joshua-jerred/Giraffe/hardware/readme.md

# Giraffe Hardware

- KiCad 7+
- All symbols should be in the `./symbols/` directory
- All footprints should be in the `./footprints/` directory

Slowly moving to a more modular design and better documentation.

## Flight Computer
- ./giraffe_flight_computer/
- ./power_board/
