joshua-jerred/Giraffe/src/power_board_pico/README.md

# Power Board Pico

Start of a pico/rp2040 project.

## External Comms

Comms via basic UART interface.

### Commands

All commands start with `cmd ` followed by the command and arguments.

- `cmd gps nav` get gps nav data

- `cmd nv test` test non-volatile memory
