joshua-jerred/Giraffe/hardware/power_calculation.md

# Hardware Power Calculation

| Item | Idle | Max | Est. |
| --- | --- | --- | ---- |
| Pi Zero 2 | 110ma@5v | 300ma@5v | |
