joshua-jerred/Giraffe/docs/hardware/battery_pack_design.md

# Battery Pack Design

The battery pack is a simple 18650 cell holder with 3d printed parts.
