joshua-jerred/Giraffe/docs/ground_station.md

# Ground Station

[ground_station](uml/giraffe_software_topology.puml)

!include tic_seq_api_calls.puml
