joshua-jerred/Giraffe/docs/ports.md

GFS Socket: 7893
GGS Backend HTTP: 7892
Web Server: 3000
MySQL: 3306
