joshua-jerred/Giraffe/docs/status_led.md

# Status LED

## Green

- Solid: Flight Phase in Pre-Launch
- Blinking: Flight Phase in Launch/Recovery
- Off: Ascent/Descent

## Blue

- Blinking: Extension module starting/inactive extensions

## Red

- Blinking: Active Error
