joshua-jerred/Giraffe/docs/giraffe_paths.md

# Giraffe Paths

## Primary Directory

The configuration and data files for Giraffe will be stored in the user's home
directory in a folder called `.giraffe`. This folder will be created if it does
not already exist.

In the ground station, all file paths are created in `file_paths.js`.
