joshua-jerred/Giraffe/docs/acronyms.md

Using acronyms because I can and I like to keep it confusing:

- GFS: Giraffe Flight System

- GFC: Giraffe Flight Computer
  - GFC Hat: The Giraffe Flight Computer Hat (Top PCB)
  - GFC Shoe: The Giraffe Flight Computer Shoe (Bottom PCB)

- GGS: Giraffe Ground Station

- GWC: Giraffe Web Client

- GDL: Giraffe Data Link
