joshua-jerred/Giraffe/hardware/power_board/giraffe_flight_computer_footprints/MolexSmaConnector.step

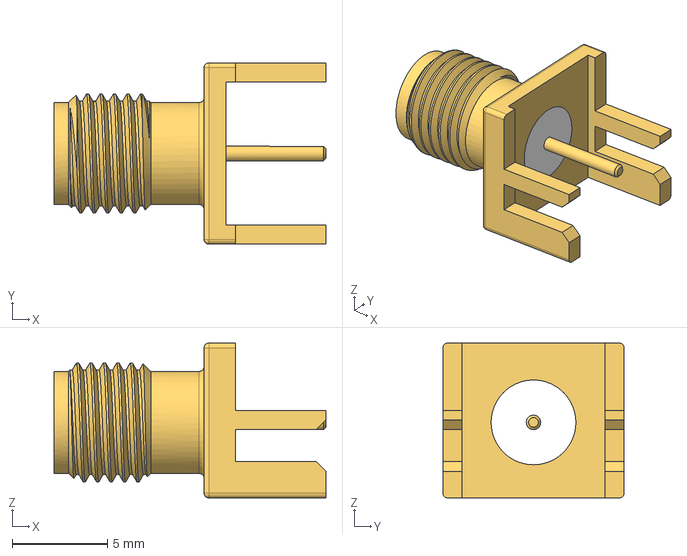
[picture p2: CAD file, 2024-01-05]
hardware/power_board/giraffe_flight_computer_footprints/MolexSmaConnector.step
14.3 x 9.53 x 8.12 mm
