joshua-jerred/Giraffe/hardware/Prototype Boards/5v Buck Supply V2/footprints/5015.step

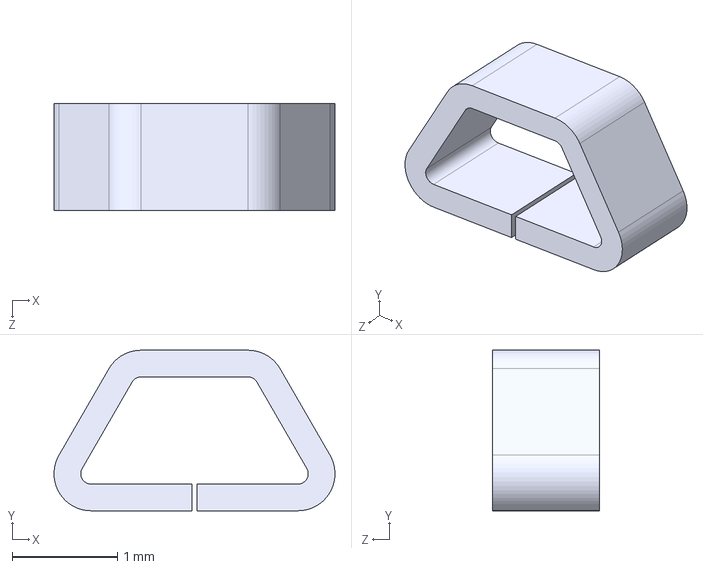
[picture p3: CAD file, 2024-10-27]
hardware/Prototype Boards/5v Buck Supply V2/footprints/5015.step
2.67 x 1.52 x 1.02 mm
