joshua-jerred/Giraffe/hardware/Prototype Boards/5v Buck Supply V2/tmp_import/INA2180A1IDGKR/INA2180A1IDGKR.step

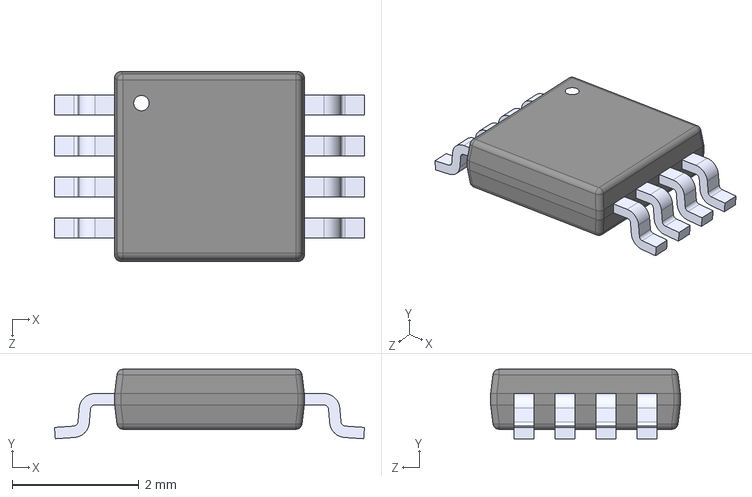
[picture p4: CAD file, 2024-10-27]
hardware/Prototype Boards/5v Buck Supply V2/tmp_import/INA2180A1IDGKR/INA2180A1IDGKR.step
4.90 x 1.10 x 3.00 mm
