joshua-jerred/Giraffe/hardware/Prototype Boards/5v Buck Supply V2/tmp_import/INA4180A1IPWR/INA4180A1IPWR.step

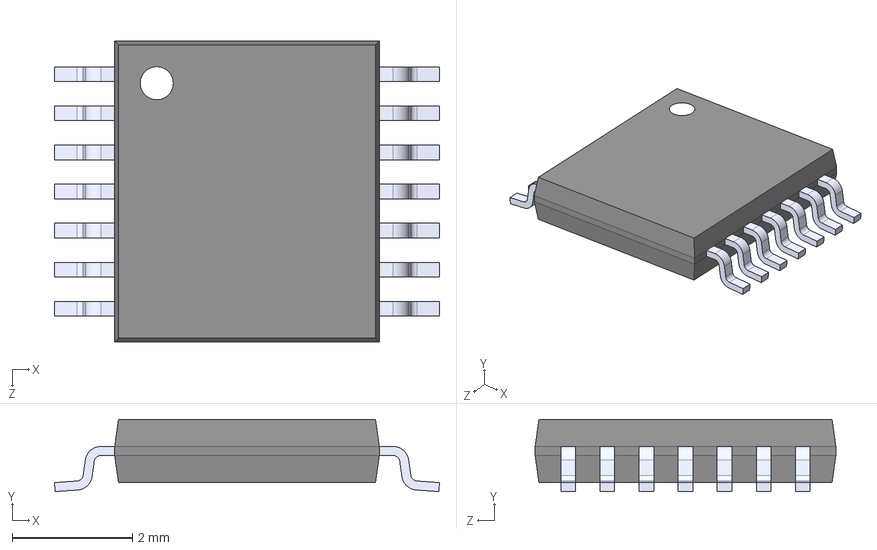
[picture p5: CAD file, 2024-10-27]
hardware/Prototype Boards/5v Buck Supply V2/tmp_import/INA4180A1IPWR/INA4180A1IPWR.step
6.40 x 1.20 x 5.00 mm
