joshua-jerred/Giraffe/hardware/flight_enclosure/enclosure.FCStd

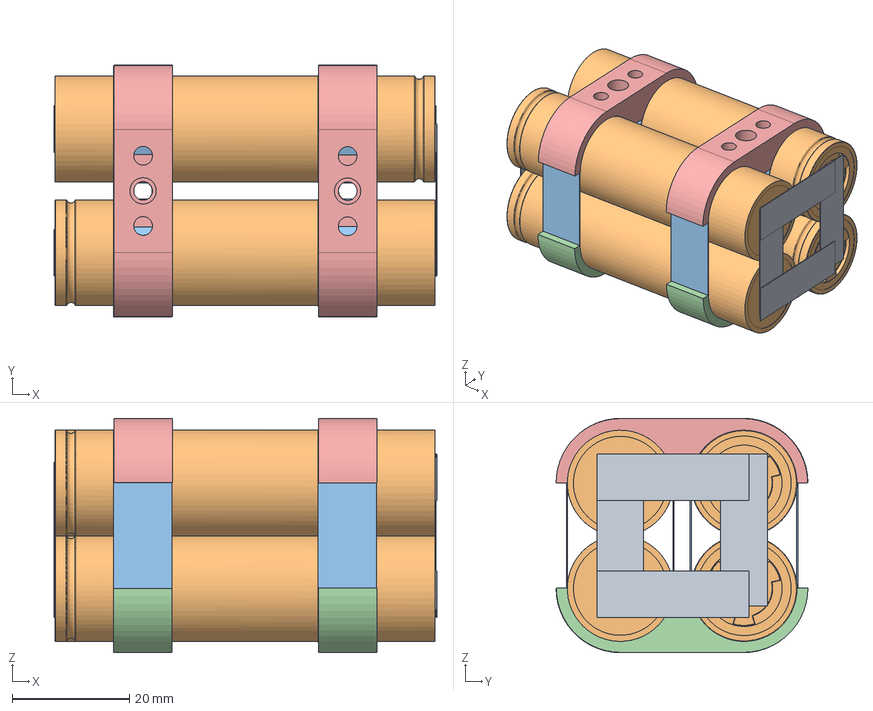
[picture p6: CAD file, 2025-07-18]
hardware/flight_enclosure/enclosure.FCStd
65.5 x 43.1 x 40.1 mm
nickel_strip x 6
kaptop_tape_wrap x 4
18650_cell_holder_bottom x 2
18650_cell_holder_top x 2
