joshua-jerred/Giraffe/hardware/giraffe_flight_computer/giraffe_flight_computer_footprints/SAM-M8Q-0.STEP

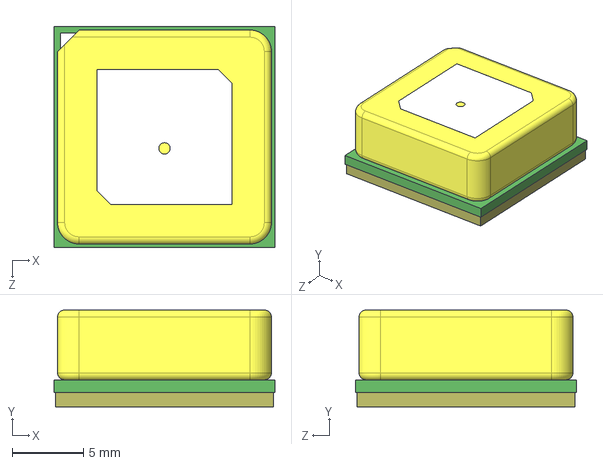
[picture p7: CAD file, 2025-07-18]
hardware/giraffe_flight_computer/giraffe_flight_computer_footprints/SAM-M8Q-0.STEP
15.5 x 6.80 x 15.5 mm
