joshua-jerred/Giraffe/hardware/power_board/giraffe_flight_computer_footprints/CAT24C32WI_GT3.step

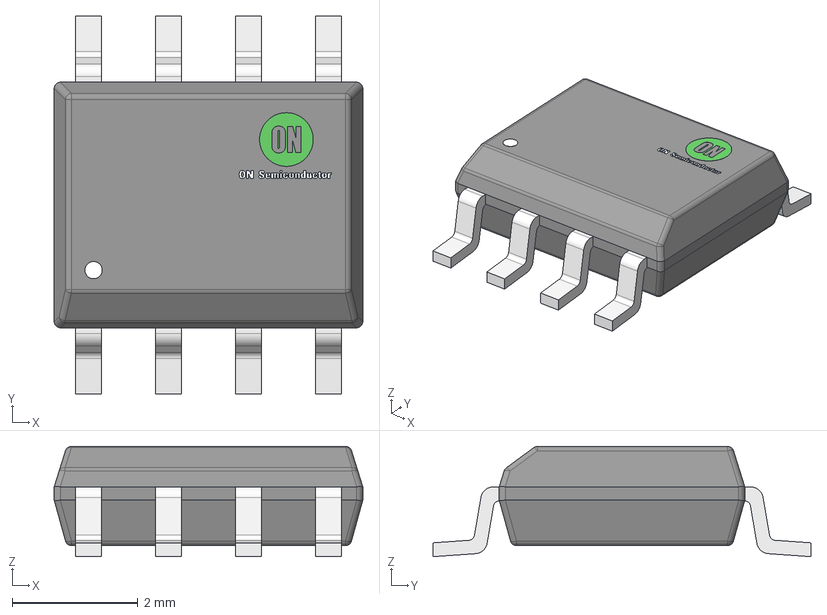
[picture p8: CAD file, 2024-01-05]
hardware/power_board/giraffe_flight_computer_footprints/CAT24C32WI_GT3.step
4.90 x 6.00 x 1.75 mm
