joshua-jerred/Giraffe/hardware/Prototype Boards/5v Buck Supply V2/footprints/INA180A1IDBVT.step

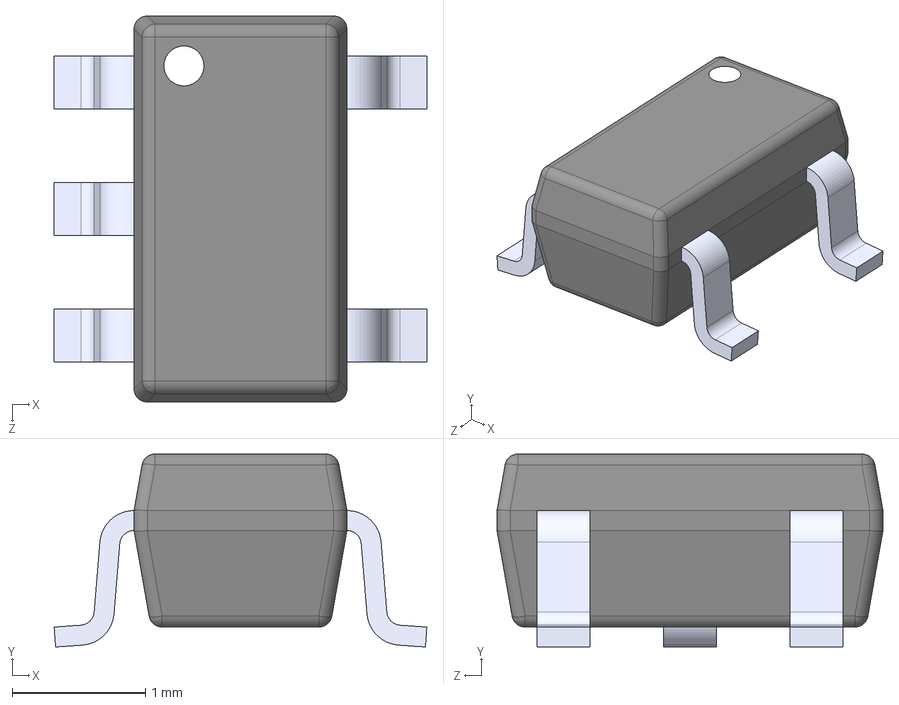
[picture p9: CAD file, 2024-10-27]
hardware/Prototype Boards/5v Buck Supply V2/footprints/INA180A1IDBVT.step
2.80 x 1.45 x 2.90 mm
