joshua-jerred/Giraffe/hardware/power_board/giraffe_flight_computer_footprints/BMI088.step

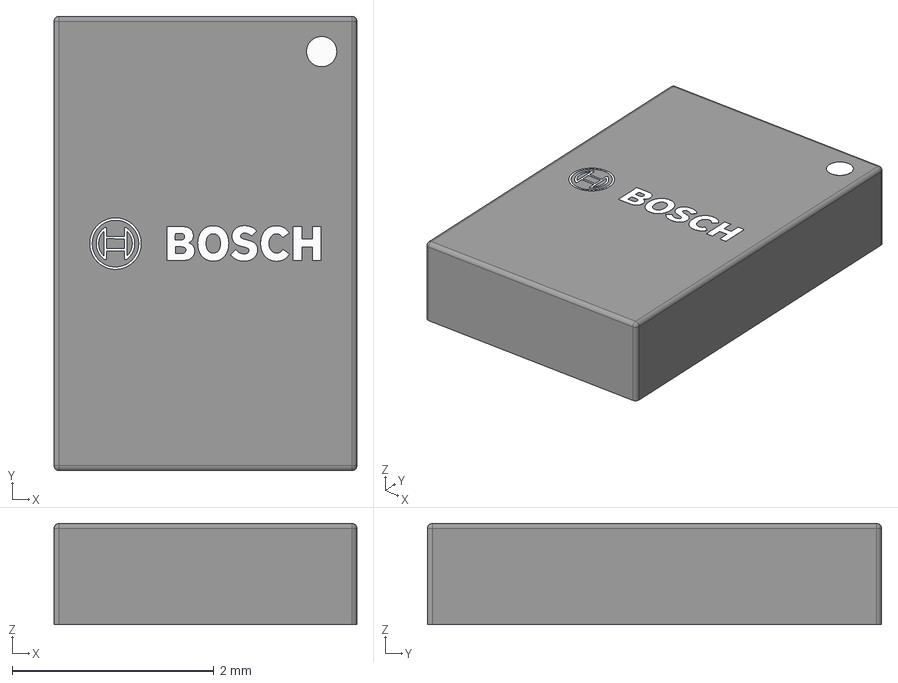
[picture p10: CAD file, 2024-01-05]
hardware/power_board/giraffe_flight_computer_footprints/BMI088.step
3.00 x 4.50 x 1.00 mm
Package
Pads
Mark1
Mark2
Logo
