joshua-jerred/Giraffe/hardware/power_board/giraffe_flight_computer_footprints/Murata_-_LQH3NPH680MMEL.step

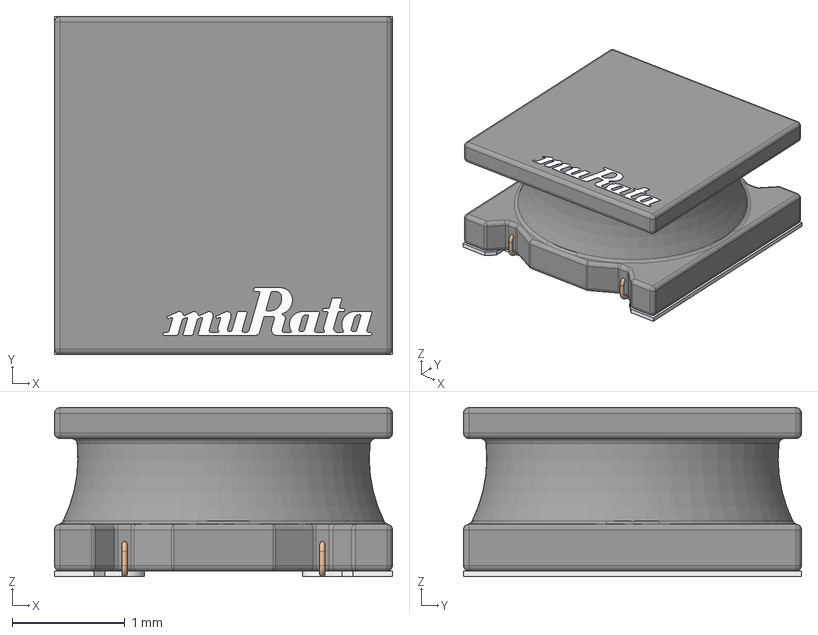
[picture p11: CAD file, 2024-01-05]
hardware/power_board/giraffe_flight_computer_footprints/Murata_-_LQH3NPH680MMEL.step
3.00 x 3.00 x 1.50 mm
logo
terminals
wire
