joshua-jerred/Giraffe/hardware/giraffe_flight_computer/giraffe_flight_computer_footprints/SRU1048-100Y.step

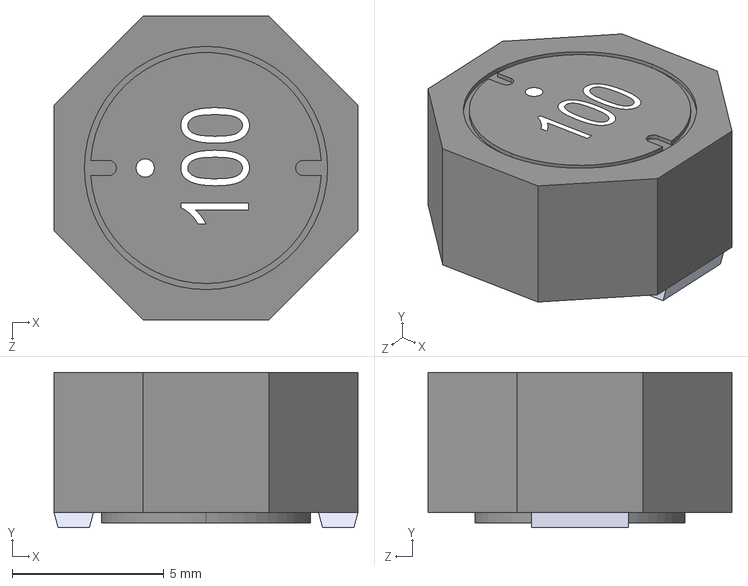
[picture p12: CAD file, 2024-10-27]
hardware/giraffe_flight_computer/giraffe_flight_computer_footprints/SRU1048-100Y.step
10.0 x 5.10 x 10.0 mm
