joshua-jerred/Giraffe/hardware/2171790001.stp

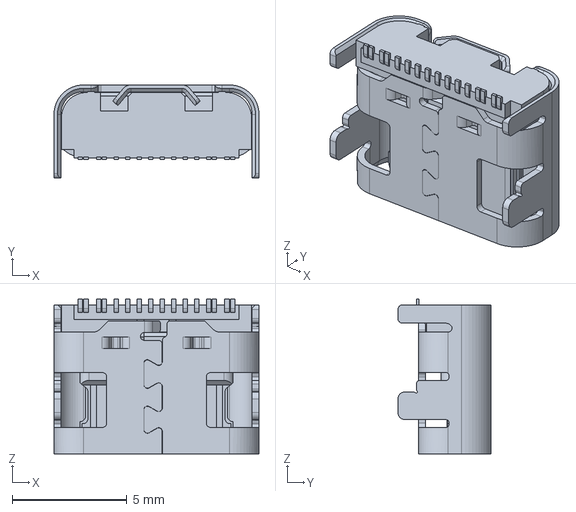
[picture p13: CAD file, 2025-07-18]
hardware/2171790001.stp
8.94 x 4.06 x 6.75 mm
