joshua-jerred/Giraffe/hardware/giraffe_flight_computer/giraffe_flight_computer_footprints/5037630491.stp

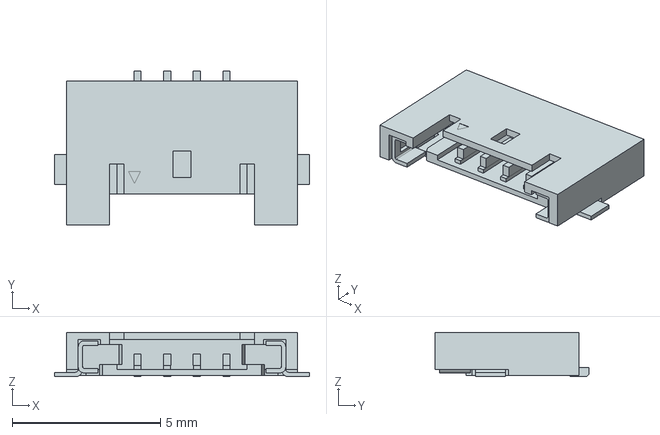
[picture p14: CAD file, 2025-07-18]
hardware/giraffe_flight_computer/giraffe_flight_computer_footprints/5037630491.stp
8.60 x 5.19 x 1.50 mm
