joshua-jerred/Giraffe/hardware/Prototype Boards/5v Buck Supply V2/tmp_import/TPS54302DDCR/TPS54302DDCR.step

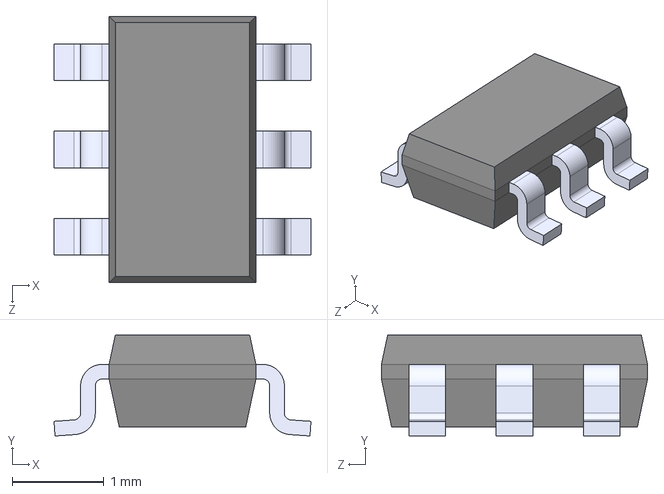
[picture p15: CAD file, 2024-10-27]
hardware/Prototype Boards/5v Buck Supply V2/tmp_import/TPS54302DDCR/TPS54302DDCR.step
2.80 x 1.10 x 2.90 mm
