joshua-jerred/Giraffe/hardware/giraffe_flight_computer/giraffe_flight_computer_footprints/436500301.stp

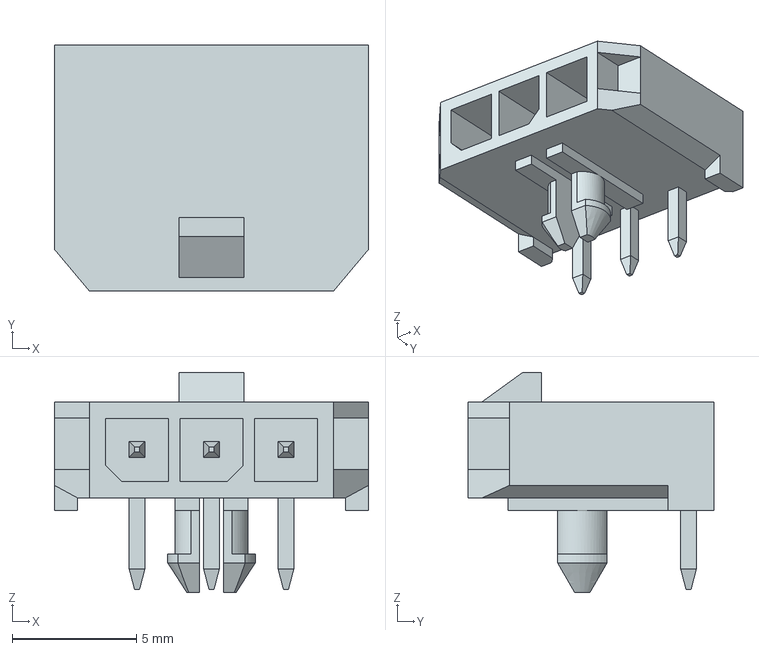
[picture p16: CAD file, 2025-07-18]
hardware/giraffe_flight_computer/giraffe_flight_computer_footprints/436500301.stp
12.7 x 9.90 x 8.87 mm
