joshua-jerred/Giraffe/(list of files, cad)

Other CAD files:
hardware/flight_enclosure/battery_pack.FCStd
hardware/giraffe_flight_computer/giraffe_flight_computer_footprints/MAX11613EUAT.step
