joshua-jerred/Giraffe/tests/test-list.md

# Unit Tests
Uses gtest, many of these are out of date and need to be updated.

## Test List
- [Test 01] - Data Stream
- [Test 02] - Configuration Module
- [Test 03] - Data Module
- [Test 04] - Extension Module (Not Yet Implemented)
- [Test 05] - I2C Interface
- [Test 06] - BMP180 Extension
- [Test 07] - DS18B20 Extension
- [Test 08] - u-blox UBX Utility test
- [Test 09] - u-blox UBX Manual Test
- [Test 10] - BME280 Extension
- [Test 11] - SYSINFO Extension
- [Test 12] - MCP3021 Extension
- [Test 13] - Image Processing Utility
- [Test 14] - Serial Interface
