joshua-jerred/Giraffe/tests/test-13/test-image.png

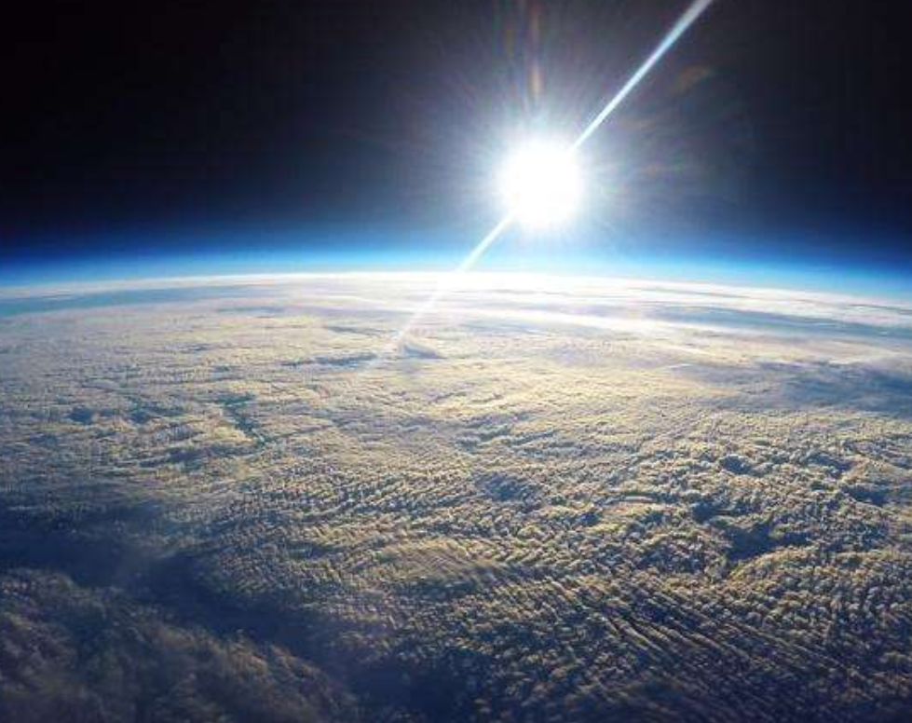
tests/test-13/test-image.png
