joshua-jerred/Giraffe/(threads)

Thread 6 (2022-10-15):

Implement Error Frame

joshua-jerred, 2022-10-15:
Implement an error frame similar to the data frame. Utilize the expiry time to clear errors.
This needs to be done with either a vector, map, or queue.

If the expiration time is '0' the error does not expire.

Closed 2022-10-31.

Thread 8 (2022-10-15):

Fix the shutdown process

joshua-jerred, 2022-10-15:
The shutdown is currently an absolutely unsafe disaster as there are many threads that are killed during the shutdown. CTRL+C is handled but it currently doesn't do anything.

The shutdown function should request that all sensors stop and shut down before turning off.
May need to implement some form of an interrupt within the modules/extensions that use threading.
_____
Edit:
Segfault on exit currently as the extensions are trying to access the data stream when it does not exist.

Closed 2022-10-26.

Thread 19 (2022-10-26):

Console Module - Include error frame

joshua-jerred, 2022-10-26:

Closed 2022-10-31.

Thread 30 (2022-11-03):

SAM-M8Q Extension

joshua-jerred, 2022-11-03:

joshua-jerred, 2022-12-28:
Eventually needs to be redone with SPI instead of DDC as even 'basic' GPS data messages are ~95 bytes. I'm not all that happy with the u-blox implementation of I2C via DDC, but they ensure that you can verify data integrity. It does still work perfectly along side another I2C sensor 151c58173fe88556e30dce18381f897edefdf0bb

Closed 2022-12-28.

Thread 39 (2022-12-11):

BME280 Driver

joshua-jerred, 2022-12-11:
The BMP180 is no longer made and there are better options.

Look into:
BMP390
BME280 - Contains RH and Temperature in a similar package size

joshua-jerred, 2022-12-19:
Going with the BME280, need to create an extension for this sensor (I2C)

joshua-jerred, 2022-12-31:
15cafeb3d115dfe9757dc09af1d4fe57048497b0

Basic driver implemented

Closed 2022-12-31.

Thread 40 (2022-12-11):

Extension shutdown

joshua-jerred, 2022-12-11:
Extension shutdown is currently really messy and often results in seg faults. This needs to be fixed.

joshua-jerred, 2022-12-16:
Fixed in [6c97428d59c64374747a181c28abdd812ccbb2c0](https://github.com/joshua-jerred/Giraffe/commit/6c97428d59c64374747a181c28abdd812ccbb2c0)

Closed 2022-12-16.

Thread 43 (2022-12-17):

Prepare development branch for merge

joshua-jerred, 2022-12-17:
Prepare 0.2 for merge
- [x] fix and remaining small bugs
- [x] remove residual files
- [x] update change log in doc
- [x] fix unit tests for current changes

Closed 2022-12-17.

Thread 47 (2022-12-19):

I2C utility needs better error handling

joshua-jerred, 2022-12-19:

joshua-jerred, 2022-12-20:
Fixed the majority of problems and added better error handling/safety.
17609eb8bf8b683ef3c91415e47f77881737d0ba

The Linux kernel I2C header is supposedly not thread-safe, so this will have to be updated at some point.

Closed 2022-12-20.

Thread 51 (2022-12-21):

Thread safe I2C Transactions

joshua-jerred, 2022-12-21:
Implement 'utility-interface-control.h' into I2C

joshua-jerred, 2023-01-04:
24b8e0c5fffe347b482f4ab4776dde5a63b8f6dd

Closed 2023-01-04.

Thread 52 (2022-12-21):

'DataModule::checkForStaleErrors()' segfault

joshua-jerred, 2022-12-21:
Segfault in the data module when checking for stale errors.
```c++
  for (auto& [source_and_unit, packet] : errorframe_) {
    if (packet.expiration_time == 0) {  // 0 means it never expires
      continue;
    }
    if ((int)packet.expiration_time < (int)now) {
      errorframe_.erase(source_and_unit);
    }
  }
```
Valgrind output:
```
==209221== Thread 2:
==209221== Invalid read of size 8
==209221==    at 0x178962: std::__detail::_Hash_node<std::pair<std::__cxx11::basic_string<char, std::char_traits<char>, std::allocator<char> > const, ErrorStreamPacket>, true>::_M_next() const (hashtable_policy.h:283)
==209221==    by 0x177B8E: std::__detail::_Node_iterator_base<std::pair<std::__cxx11::basic_string<char, std::char_traits<char>, std::allocator<char> > const, ErrorStreamPacket>, true>::_M_incr() (hashtable_policy.h:300)
==209221==    by 0x176F77: std::__detail::_Node_iterator<std::pair<std::__cxx11::basic_string<char, std::char_traits<char>, std::allocator<char> > const, ErrorStreamPacket>, false, true>::operator++() (hashtable_policy.h:352)
==209221==    by 0x175BAA: DataModule::checkForStaleErrors() (module-data.cpp:204)
==209221==    by 0x175C6D: DataModule::runner() (module-data.cpp:231)
==209221==    by 0x17C7FB: void std::__invoke_impl<void, void (DataModule::*)(), DataModule*>(std::__invoke_memfun_deref, void (DataModule::*&&)(), DataModule*&&) (invoke.h:74)
==209221==    by 0x17C74E: std::__invoke_result<void (DataModule::*)(), DataModule*>::type std::__invoke<void (DataModule::*)(), DataModule*>(void (DataModule::*&&)(), DataModule*&&) (invoke.h:96)
==209221==    by 0x17C6AE: void std::thread::_Invoker<std::tuple<void (DataModule::*)(), DataModule*> >::_M_invoke<0ul, 1ul>(std::_Index_tuple<0ul, 1ul>) (std_thread.h:253)
==209221==    by 0x17C663: std::thread::_Invoker<std::tuple<void (DataModule::*)(), DataModule*> >::operator()() (std_thread.h:260)
==209221==    by 0x17C643: std::thread::_State_impl<std::thread::_Invoker<std::tuple<void (DataModule::*)(), DataModule*> > >::_M_run() (std_thread.h:211)
==209221==    by 0x49582B2: ??? (in /usr/lib/x86_64-linux-gnu/libstdc++.so.6.0.30)
==209221==    by 0x4C43B42: start_thread (pthread_create.c:442)
==209221==  Address 0x4e38130 is 0 bytes inside a block of size 152 free'd
==209221==    at 0x484BB6F: operator delete(void*, unsigned long) (in /usr/libexec/valgrind/vgpreload_memcheck-amd64-linux.so)
```

joshua-jerred, 2022-12-21:
```c++
  ErrorFrame::iterator it = errorframe_.begin();
  while (it != errorframe_.end()) {
    if (it->second.expiration_time == 0) { // 0 mean it never expires}
      it++;
      continue;
    }
    if ((int)it->second.expiration_time < (int)now) {
      it = errorframe_.erase(it); // erase returns the next iterator
    } else {
      it++;
    }
  }
```

The iterator was being deleted, a simple fix.

7a86255bd87e4a414d93750587fa75f2e5a4e0d2

Closed 2022-12-21.

Thread 56 (2022-12-27):

Finalize Extension List

joshua-jerred, 2022-12-27:
### Environmental
- [x] Pressure Sensor (BME280)
- [x] Temperature Sensor(s) (DS18B20, BME280)
- [x] Humidity Sensor (BME280)
- [x] Light Sensor(s) UVA, UVB, UVC, or wide spectrum UV sensor. Visible spectrum sensor for RGB.
      - TSL25911FN
      -  LTR390

### Location/Physical Sensors
- [x] GPS Sensor (SAM-M8Q)
- [x] Accelerometer / Gyro (BMI055)

### System Sensors
- [x] Voltage/Battery Fuel Gauge sensor (MAX17048G)
- [x] On PCB Thermocouple - Not needed. Between the BME280 on the board and CPU temp, this isn't that important.

### Radio
- [x] VHF Radio Module (DRA818)
- [x] Audio Input/Output for radio (TI PCM2902C)

Closed 2023-01-02.

Thread 61 (2023-01-02):

UBX Protocol - Poll data instead of streaming it

joshua-jerred, 2023-01-02:

joshua-jerred, 2023-01-05:
d8551d8689bac853fadae47fe5ba43d966cfc4c2 As good as this is going to get for now, eventually, another method needs to be used. Either SPI or hand the work over to an MCU that will read and parse the data that can then be read via simple I2C commands.

Closed 2023-01-05.

Thread 63 (2023-01-07):

Prepare for Merge of the 0.3 iteration development branch with main

joshua-jerred, 2023-01-07:
- [x] Fix all file Doxygen headers
- [x] Prepare hardware for unit tests
- [x] Finish refactor #54
- [x] Change all version numbers
- [x] Run a 'comprehensive' test on the GFS in the Pi Environment
- [x] Pass all unit tests
- [x] Generate and Publish Doxygen docs
- [x] Update Readme
  - [x] Publish Schematic for GFC Prototype 2
  - [x] Updated image of the web server

Closed 2023-01-07.

Thread 68 (2023-01-22):

Implement - Configuration error detection/error catching (General Configuration Safety)

joshua-jerred, 2023-01-22:
This is the most 'unsafe' part of GFS currently. The JSON library is throwing exceptions and they are not being caught.

Every configuration item needs to do some form of error detection as well.

A large overhaul of the Configuration Module may be needed.

Closed 2023-05-23.

Thread 69 (2023-01-22):

Implement - Log Levels

joshua-jerred, 2023-01-22:
A more universal approach to the 'errorStream'

- [ ] - [ ] Configuration
   - [ ]  Log Level
   - [ ]  Print Log
- [ ] Data Stream
  - [ ] Change 'ErrorPacket' and supporting methods to 'LogPacket'
  - [ ] Add 'level' to LogPacket

  The following will only do something if the configured error level is at that level, or lower.
  - [ ] addDebug()
  - [ ] addInfo()
  - [ ] addCritical()
  - [ ] addWarn()
  - [ ] Update addError()

- [ ] Data Module
  - [ ] Parse the LogPacket/DebugPacket
      - [ ] Debug Packets: Write to a file or print output
  - [ ] Critical/Warn/Error
      - [ ] These need to go into what was previously called the 'error frame'

Thread 71 (2023-01-22):

Implement - Location Data

joshua-jerred, 2023-01-22:
The Data Module needs to parse GPS packets as they arrive to maintain the following in the data stream:

- [x] Last Good GPS Fix
- [x] Current GPS Data
   - [x] Includes 'GPS Status' which is a boolean value that is set to true if the GPS packets are arriving
   - [ ] An expiration time (currently undefined) will state when the data is no longer considered good

joshua-jerred, 2023-03-21:
60f16c055d345da12f81e3e93f51ab75563ef235

Closed 2023-03-21.

Thread 76 (2023-01-22):

Fix - Use Available Memory, not Free Memory

joshua-jerred, 2023-01-22:
Currently the system extension is using 'Free Memory' which is not useful as Linux will use as much as it can. Available memory is more more relevant.

Closed 2023-06-24.

Thread 101 (2023-06-02):

Implement - Data Module Info/Error log to file

joshua-jerred, 2023-06-02:
Inside of `data_log.cpp`.

The function prototype is already there.

Closed 2023-06-08.

Thread 110 (2023-06-30):

Feature/DataModule/FileLog/Errors

joshua-jerred, 2023-06-30:
Errors (log items) need to be implemented to file logging.

- [x] As they come in
- [x] The current active errors for a given time, including none

Closed 2023-07-01.

Thread 111 (2023-06-30):

Feature/DataModule/DataFrame/Voltages

joshua-jerred, 2023-06-30:
A data frame should be generated for voltages along with the relevant data IDs

- Bus Voltages
- Battery Voltages

Closed 2024-10-28.

Thread 117 (2023-06-30):

Feature/DataModule/ErrorFrame

joshua-jerred, 2023-06-30:
A map of errors:

```
errorMap[ErrorId]: ErrorContainer

struct ErrorContainer{
 MostRecentTimestamp // The timestamp of the last time it was thrown
 TimesReported // The current number of error reports, this will be non-zero
// Items should be logged prior to clearing
// Remove from the map once cleared
}
```

Closed 2023-07-01.

Thread 122 (2023-06-30):

Feature/Extension/BMP180Update

joshua-jerred, 2023-06-30:
Re-Implement the extension

joshua-jerred, 2024-01-16:
Not needed anymore. BME280 is the replacement device

Closed 2024-01-16.

Thread 171 (2024-01-13):

TCP Socket Reliability

joshua-jerred, 2024-01-13:
The current TCP socket implementation in not reliable. Although it's functional, it has all sorts of problems with the current ground station.

Thread 207 (2024-02-15):

Hard Fault on invalid bme280 config

joshua-jerred, 2024-02-15:
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

joshua-jerred, 2024-02-15:
The fault is not related to the config. However, the issue with the config was treating the bme280 enabled option as a string.

joshua-jerred, 2024-02-15:
The current assumption is that it's related to the following lines as it has only been seen soon after adding a samm8q in the config.

https://github.com/joshua-jerred/Giraffe/blob/c79d168e90ba4295580119f2163c120147790046/src/flight_system/extensions/samm8q.cpp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

Data reliability with the SAMM8Q needs to be revisited. See issue #210

Closed 2024-02-15.

Thread 210 (2024-02-15):

SAM-M8Q Data Reliability

joshua-jerred, 2024-02-15:
Currently, the SAM-M8Q extension will generate erroneous data. This might be related to using I2C as it has been a challenge. CRC checking should also be inspected.

Examples:
https://github.com/joshua-jerred/Giraffe/blob/c79d168e90ba4295580119f2163c120147790046/src/flight_system/extensions/samm8q.cpp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

This raises a fault at times. Values will be wildly erroneous even in valid frames.

Thread 211 (2024-02-15):

BME280 Pressure Reliability

joshua-jerred, 2024-02-15:
The pressure data from the BME280 is reliant on "compensation data". If this data is reliant on the temperature, this could cause issues with the pressure data as the sensor is on the PCB and will probably be *much* warmer than the outside air.

Thread 212 (2024-02-15):

Allow For GFS Address changes

joshua-jerred, 2024-02-15:
Currently, changing the address of GFS requires a restart of the GGS. Implement a change so that the GGS does not need to be reset when the user changes the address.

Thread 214 (2024-02-15):

Implement generic 'Flight Logic'

joshua-jerred, 2024-02-15:
Create a way to quickly add logic that can control/look at:
- Flight Phase (see dependent issues)
- Battery Saving Mode
- Send Alerts if GPS data is lost

Closed 2024-06-08.

Thread 215 (2024-02-15):

Implement 'Flight Phase'

joshua-jerred, 2024-02-15:
Dependent on #214

Flight Phases:
- [x] Pre-Launch: Starting mode, ~~(no telemetry?)~~
- [x] Launch: Switch from pre-launch is a manual switch made via a command sent via TCP (Web Client)
- [x] Ascent: The switch from launch to ascent should happen as soon as the flight computer begins to increase in altitude.
- [x] Descent: Dependent on detecting a balloon pop (Separate Issue)
- [x] Recovery: Switch to this mode when the flight computer has landed.

Flight Phase needs to be added to flight_runner_data so that it's immune to hard faults.

The current flight phase also needs to be within shared data

Add the data to the data stream and the server module.

Closed 2024-06-08.

Thread 233 (2024-02-15):

Plan battery voltage/soc data location

joshua-jerred, 2024-02-15:
Possibly dependent on #234

In the flight software, where does SOC/battery voltage come from? It will originally come from an ADC extension, but will it come in as the raw data, or as something else?

Closed 2024-10-28.

Thread 234 (2024-02-15):

ADC Channel Mapping

joshua-jerred, 2024-02-15:
First, determine how to differentiate the labels of ADC channels. Currently, the data module supports single channel ADCs well as they have unique extension names, but if there are multiple inputs this could cause problems. One idea is to generate unique enum values for channels 0-n (probably 0-7 for now, no idea why more would be needed).

Thread 262 (2024-04-26):

Implement 'mission clock'

joshua-jerred, 2024-04-26:
The ground station and the web client both need to be aware of the 'mission clock'.
A launch time should be set via the web client and sent to the flight software.

- Mission clock display on the web client with start time, and time elapsed.
- Have a method to reset this clock and to pause it.
- This will be used to do sequencing on the FC side
- Need to detect clock sway, especially when on the ground.

Closed 2024-06-08.

Thread 282 (2024-10-20):

IMU Axis Remap

joshua-jerred, 2024-10-20:
This doesn't necessarily have to be in the config JSON, but there must exist a way to to re-map the orientation of an IMU to allow for them to be installed in any way.
