joshua-jerred/Giraffe/hardware/GFC Hat/GFC-Hat.kicad_pcb

## KiCad design hardware/Prototype Boards/legacy/GFC Hat/GFC-Hat.kicad_pcb (2023-06-30, an earlier design)

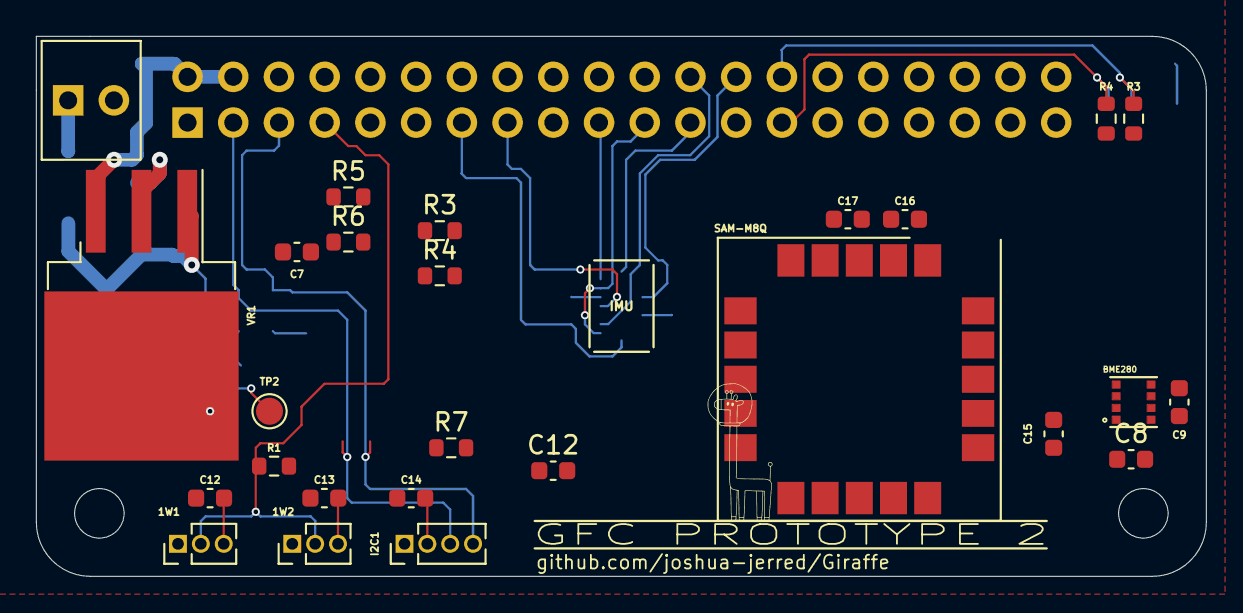
[picture p21: board GFC-Hat.kicad_pcb from above]

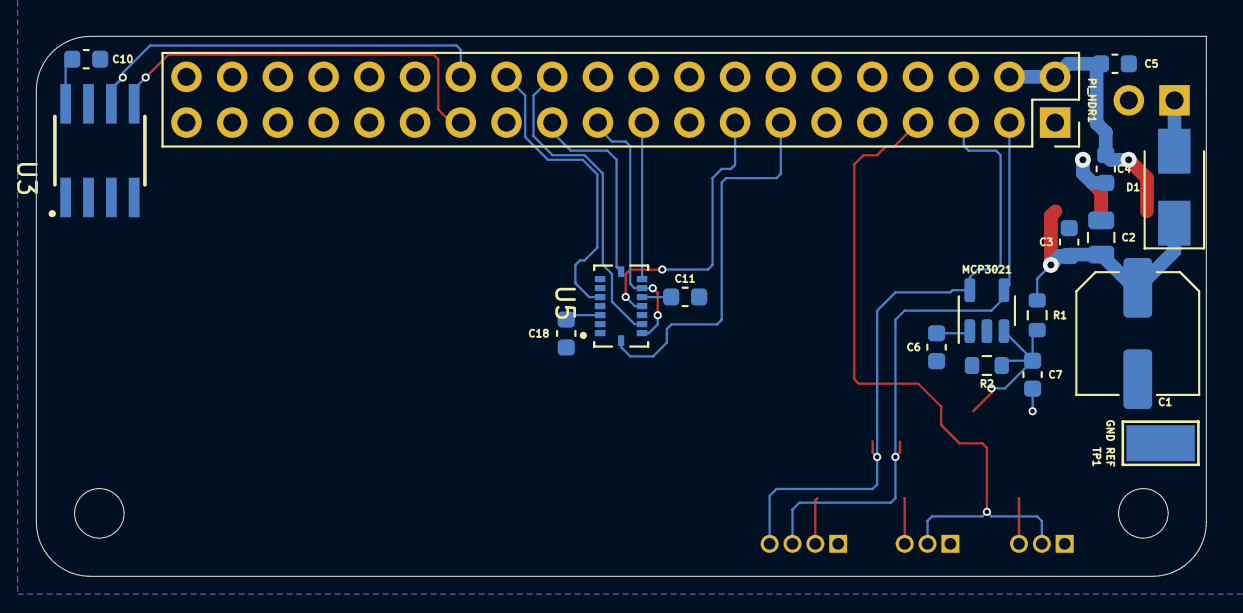
[picture p22: board GFC-Hat.kicad_pcb from below]

Board: 4 copper layers, 65.0 x 30.0 mm, 44 parts (18 on the bottom side), 19 nets.

Parts:
1W1, 1W2: 1-Wire; PinHeader_1x03_P1.27mm_Vertical
C1: 100µF; C_Elec_6.3x7.7
C2: 1µF; C_0805_2012Metric
C3, C4, C5, C6, C7, C7#2, C8, C9, C10, C11, C12, C12#2, C13, C14, C15, C16, C17, C18: 0.1µF; C_0603_1608Metric
D1: 2A LFV; D_SMA
I2C1: I²C; PinHeader_1x04_P1.27mm_Vertical
J1: BAT; OSTVN02A150 2x1 Terminal Block
PI_HDR1: PI; PinSocket_2x20_P2.54mm_Vertical
R1, R1#2: 30kΩ; R_0603_1608Metric
R2: 7.5kΩ; R_0603_1608Metric
R3, R3#2, R4, R4#2: 3.9kΩ; R_0603_1608Metric
R5, R6: *; R_0603_1608Metric
R7: 4.7kΩ; R_0603_1608Metric
TP1: GND REF; TestPoint_Keystone_5019_Minature
TP2: BAT REF; TestPoint_Pad_D1.5mm
U1: MCP3021; SOT-23-5
U2: BME280; PSON65P250X250X100-8N
U3: CAT24C32; SOIC127P600X175-8N
U4: SAM-M8Q; ublox_SAM-M8Q
U5: BMI088; PQFN50P450X300X100-16N
VR1: LM7805; TO-263-3_TabPin2

Connections:
1-Wire: 1W1.2, 1W2.2, PI_HDR1.7 (GCLK0/GPIO4), R7.2
+3V3: 1W1.3, 1W2.3, C6.2, C8.2, C9.2, C10.2, C11.2, C12.2, C12#2.2, C13.2, C14.1, C15.2, C16.2, C17.1, C18.2, I2C1.2, PI_HDR1.1 (3V3), PI_HDR1.17 (3V3), R3.1, R3#2.1, R4.1, R4#2.1, R5.1, R6.2, R7.1, U1.1 (VDD), U2.2 (CSB), U2.6 (VDDIO), U2.8 (VDD), U3.8 (VCC), U4.2 (VCC_IO), U4.3 (V_BCKP), U4.17 (VCC), U5.3 (VDD), U5.11 (VDDIO)
+5V: C4.1, C5.2, PI_HDR1.2 (5V), PI_HDR1.4 (5V), VR1.3 (VO)
+BATT: D1.2 (A), J1.1
/BAT Reference Voltage: C7.2, C7#2.2, R1.2, R1#2.2, R2.1, TP2.1, U1.3 (A_IN)
BAT Polarized: C1.1, C2.1, C3.1, D1.1 (K), R1.1, R1#2.1, VR1.1 (VI)
BMI088 Int1: PI_HDR1.33 (PWM1/GPIO13), U5.16 (INT1)
BMI088 Int3: PI_HDR1.15 (GPIO22), U5.12 (INT3)
EEPROM.SCL: PI_HDR1.28 (ID_SC/GPIO1), R4.2, R4#2.2, U3.6 (SCL)
EEPROM.SDA: PI_HDR1.27 (ID_SD/GPIO0), R3.2, R3#2.2, U3.5 (SDA)
GND: 1W1.1, 1W2.1, C1.2, C2.2, C3.2, C4.2, C5.1, C6.1, C7.1, C7#2.1, C8.1, C9.1, C10.1, C11.1, C12.1, C12#2.1, C13.1, C14.2, C15.1, C16.1, C17.2, C18.1, I2C1.1, J1.2, PI_HDR1.6 (GND), PI_HDR1.9 (GND), PI_HDR1.14 (GND), PI_HDR1.20 (GND), PI_HDR1.25 (GND), PI_HDR1.30 (GND), PI_HDR1.34 (GND), PI_HDR1.39 (GND), R2.2, TP1.1, U1.2 (GND), U2.1 (GND), U2.5 (SDO), U2.7 (GND), U3.1 (A0), U3.2 (A1), U3.3 (A2), U3.4 (VSS), U4.1 (GND), U4.4 (GND), U4.5 (GND), U4.6 (GND), U4.10 (GND), U4.11 (GND), U4.15 (GND), U4.16 (GND), U4.20 (GND), U5.2 (NC), U5.4 (GNDA), U5.6 (GNDIO), U5.7 (PS), VR1.2 (GND)
GPS TX-Ready: PI_HDR1.37 (GPIO26), U4.13 (TXD)
I2C0.SCL: I2C1.3, PI_HDR1.5 (SCL/GPIO3), R6.1, U1.5 (SCL), U2.4 (SCK), U4.12 (SCL)
I2C0.SDA: I2C1.4, PI_HDR1.3 (SDA/GPIO2), R5.2, U1.4 (SDA), U2.3 (SDI), U4.9 (SDA)
SPI0.CE0: PI_HDR1.24 (~CE0/GPIO8), U5.14 (CSB1)
SPI0.CE1: PI_HDR1.26 (~CE1/GPIO7), U5.5 (CSB2)
SPI0.MISO: PI_HDR1.21 (MISO0/GPIO9), U5.10 (SDO2), U5.15 (SDO1)
SPI0.MOSI: PI_HDR1.19 (MOSI0/GPIO10), U5.9 (SDA/SDI)
SPI0.SCLK: PI_HDR1.23 (SCLK0/GPIO11), U5.8 (SCL/SCK)
