joshua-jerred/Giraffe/hardware/Prototype Boards/5v Buck Supply V2/5v Buck Supply.kicad_pcb

## KiCad design hardware/Prototype Boards/5v Buck Supply V2/5v Buck Supply.kicad_pcb (2025-07-18)

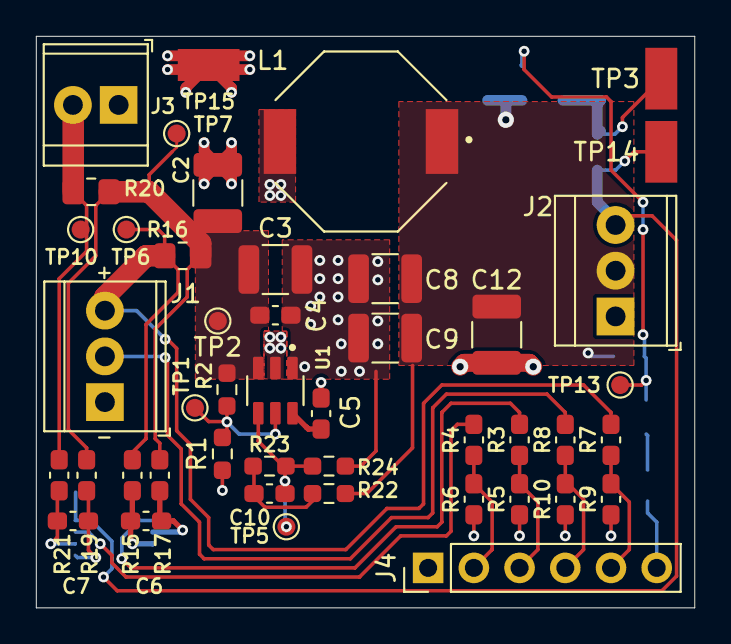
[picture p23: board hardware/Prototype Boards/5v Buck Supply V2/5v Buck Supply.kicad_pcb from above]

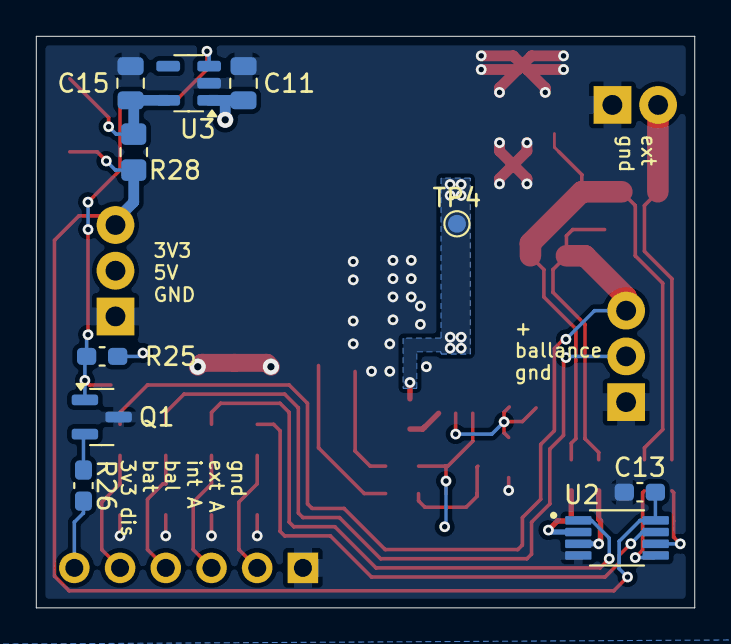
[picture p24: board hardware/Prototype Boards/5v Buck Supply V2/5v Buck Supply.kicad_pcb from below]

Board: 2 copper layers, 36.6 x 31.8 mm, 55 parts (10 on the bottom side), 26 nets.

Parts:
C2, C12: DNS; C_1210_3225Metric_Pad1.33x2.70mm_HandSolder
C3: 10uf; C_1210_3225Metric
C4, C5, C13: 0.1uf; C_0603_1608Metric_Pad1.08x0.95mm_HandSolder
C6, C7: DNS; C_0603_1608Metric_Pad1.08x0.95mm_HandSolder
C8, C9: 22uf; C_1210_3225Metric
C10: 75pf; C_0603_1608Metric_Pad1.08x0.95mm_HandSolder
C11, C15: 1uf; C_0805_2012Metric
J1: BATT; TerminalBlock_TE_282834-3_1x03_P2.54mm_Horizontal
J2: PRIMARY; TerminalBlock_TE_282834-3_1x03_P2.54mm_Horizontal
J3: EXTERNAL; TerminalBlock_TE_282834-2_1x02_P2.54mm_Horizontal
J4: IO; PinHeader_1x06_P2.54mm_Vertical
L1: 10uH; IND_SRU1048-100Y
Q1: NPN; SOT-23
R1, R2: DNS; R_0603_1608Metric_Pad0.98x0.95mm_HandSolder
R3, R4, R5, R6, R7, R8, R9, R10, R25, R26: R; C_0603_1608Metric_Pad1.08x0.95mm_HandSolder
R15, R17, R19, R21: 0; C_0603_1608Metric_Pad1.08x0.95mm_HandSolder
R16, R20, R28: R; R_0805_2012Metric_Pad1.20x1.40mm_HandSolder
R22: 49.9k; R_0603_1608Metric_Pad0.98x0.95mm_HandSolder
R23: 100k; R_0603_1608Metric_Pad0.98x0.95mm_HandSolder
R24: 13.3k; R_0603_1608Metric_Pad0.98x0.95mm_HandSolder
TP1, TP6, TP7, TP10: TestPoint; TestPoint_Pad_D1.0mm
TP2, TP4, TP5, TP13: TestPoint_Pad_D1.0mm
TP3, TP14, TP15: TestPoint; KEYSTONE_5015
U1: TPS54302DDCR; SOT95P280X110-6N
U2: INA2180Ax; SOP65P490X110-8N
U3: AP2112K-3.3; SOT-23-5

Connections:
3V3 Primary: C13.1, J2.3, R28.2, TP14.1, U2.8 (VS)
3V3_DISABLE: J4.6, R26.2
5V Primary: C8.1, C9.1, C11.1, C12.1, J2.2, L1.1, R22.1, R25.2, U3.1 (VIN)
+BATT: J1.3, R7.1, R15.1, R16.1, TP6.1
+BATT External: J3.2, R20.2, R21.1, TP10.1
+BATT Primary: C2.1, C3.1, C4.1, R2.2, R16.2, R17.1, R19.1, R20.1, TP2.1, TP7.1, U1.3 (VIN)
/3v3_en: Q1.1 (C), R25.1, TP13.1, U3.3 (EN)
/3v3_out: C15.1, R28.1, TP3.1, U3.5 (VOUT)
/adc_scaled:batt: J4.5, R7.2, R9.1
/adc_scaled:batt_ballance: J4.4, R8.2, R10.1
/adc_scaled:current_batt: J4.3, R3.2, R5.1
/adc_scaled:current_external: J4.2, R4.2, R6.1
/batt_ext+: C7.2, R19.2, U2.5 (IN+2)
/batt_ext-: C7.1, R21.2, U2.6 (IN-2)
/batt_primary+: C6.2, R15.2, U2.3 (IN+1)
/batt_primary-: C6.1, R17.2, U2.2 (IN-1)
/buck_boot: C5.1, U1.6 (BOOT)
/buck_enable: R1.2, R2.1, TP1.1, U1.5 (EN)
/buck_feedback: C10.2, R23.2, R24.1, TP5.1, U1.4 (FB)
/buck_sw: C5.2, L1.2, TP4.1, U1.2 (SW)
GND: C2.2, C3.2, C4.2, C8.2, C9.2, C11.2, C12.2, C13.2, C15.2, J1.1, J2.1, J3.1, J4.1, Q1.3 (E), R1.1, R5.2, R6.2, R9.2, R10.2, R24.2, TP15.1, U1.1 (GND), U2.4 (GND), U3.2 (GND)
unnamed: C10.1, R22.2, R23.1
unnamed: Q1.2 (B), R26.1
batt_ballance: J1.2, R8.1
current_sense_batt: R3.1, U2.1 (OUT1)
current_sense_external: R4.1, U2.7 (OUT2)
