joshua-jerred/Giraffe/hardware/GFC Shoe/GFC Shoe.kicad_pcb

## KiCad design hardware/Prototype Boards/legacy/GFC Shoe/GFC Shoe.kicad_pcb (2023-03-24, an earlier design)

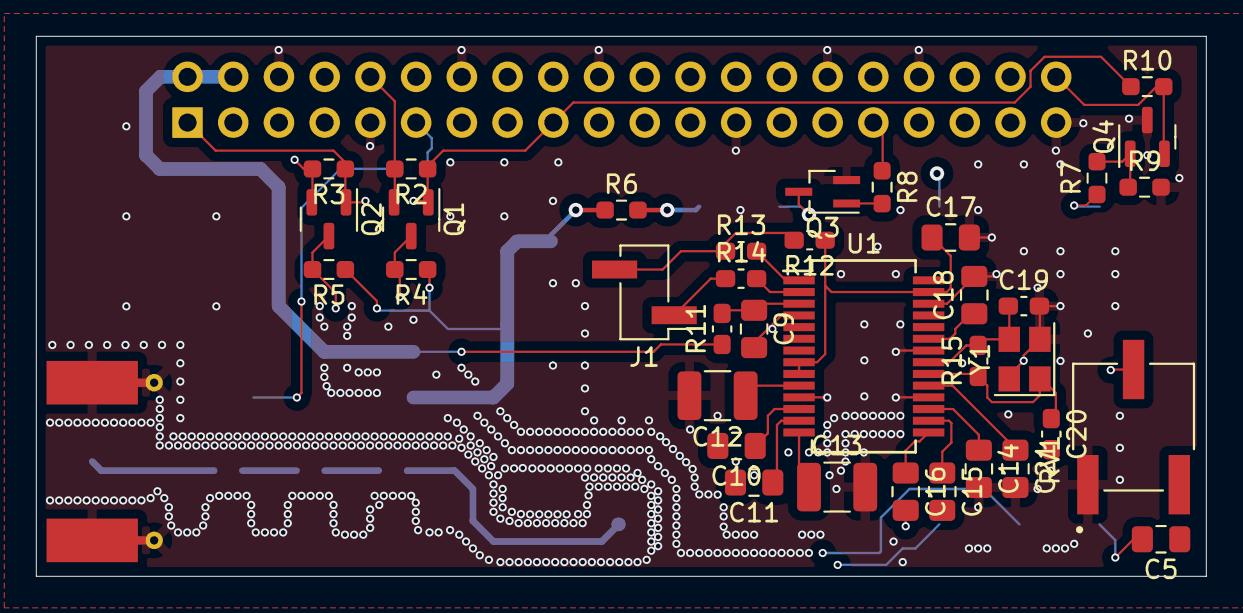
[picture p25: board GFC Shoe.kicad_pcb from above]

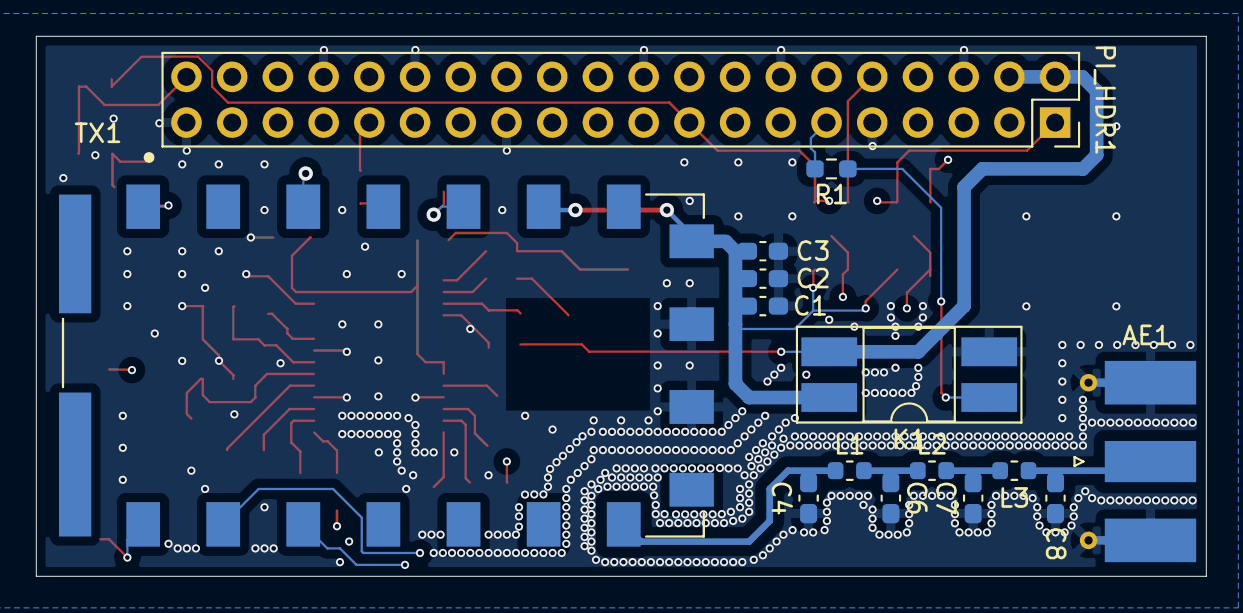
[picture p26: board GFC Shoe.kicad_pcb from below]

Board: 4 copper layers, 65.0 x 30.0 mm, 51 parts (15 on the bottom side), 42 nets.

Parts:
AE1: Antenna_Shield; SMA_Molex_73251-1153_EdgeMount_Horizontal
C1: 0.1uF; C_0603_1608Metric_Pad1.08x0.95mm_HandSolder
C2: 10kpF; C_0603_1608Metric_Pad1.08x0.95mm_HandSolder
C3: 1kpF; C_0603_1608Metric_Pad1.08x0.95mm_HandSolder
C4, C8: 20pF; C_0603_1608Metric_Pad1.08x0.95mm_HandSolder
C5, C9, C10, C11, C14, C15, C16, C17, C18, C21: 1uF; C_0805_2012Metric_Pad1.18x1.45mm_HandSolder
C6, C7: 36pF; C_0603_1608Metric_Pad1.08x0.95mm_HandSolder
C12, C13: 10uF; C_1210_3225Metric_Pad1.33x2.70mm_HandSolder
C19, C20: 10pF; C_0603_1608Metric_Pad1.08x0.95mm_HandSolder
J1: USB; PinHeader_1x02_P2.54mm_Vertical_SMD_Pin1Left
K1: TLP241A; DIP-4_W8.89mm_SMDSocket_LongPads
L1, L3: 56nH; L_0603_1608Metric
L2: 68nH; L_0603_1608Metric
PI_HDR1: PI; PinSocket_2x20_P2.54mm_Vertical
Q1, Q2: BSS138; SOT-23
Q3: DMN67D8LW-13; SOT-323_SC-70_Handsoldering
Q4: Q_NPN_BCE; SOT-23
R1: 270; R_0603_1608Metric_Pad0.98x0.95mm_HandSolder
R2, R3, R4, R5, R8: 10k; R_0603_1608Metric_Pad0.98x0.95mm_HandSolder
R6: 10K; R_0603_1608Metric_Pad0.98x0.95mm_HandSolder
R7: 100K; R_0603_1608Metric_Pad0.98x0.95mm_HandSolder
R9: 56K; R_0603_1608Metric_Pad0.98x0.95mm_HandSolder
R10: 1K; R_0603_1608Metric_Pad0.98x0.95mm_HandSolder
R11: 2.2; C_0603_1608Metric_Pad1.08x0.95mm_HandSolder
R12: 1.5k; C_0603_1608Metric_Pad1.08x0.95mm_HandSolder
R13, R14: 22; C_0603_1608Metric_Pad1.08x0.95mm_HandSolder
R15: 1M; C_0603_1608Metric_Pad1.08x0.95mm_HandSolder
RV1: 100k; TRIM_3361P-1-104GLF
TX1: SA868; DORJI_DRA818V
U1: PCM2902C; SSOP-28_5.3x10.2mm_P0.65mm
Y1: Crystal ECS33B; Crystal_SMD_3225-4Pin_3.2x2.5mm

Connections:
5VC: C1.2, C2.2, C3.2, K1.4 (Drain), R4.1, R5.1, R6.1, TX1.8 (VBAT)
+3V3: PI_HDR1.1 (3V3), PI_HDR1.17 (3V3), Q1.1 (G), Q2.1 (G), R2.1, R3.1, R10.1
+5V: K1.3 (Drain), PI_HDR1.2 (5V), PI_HDR1.4 (5V), R11.1
/SA868/A_IN: C16.2, RV1.2
/SA868/A_IN Filtered: C5.2, TX1.18 (MIC_IN)
/SA868/A_OUT: C11.2, TX1.3 (AF_OUT)
/SA868/PD: R6.2, TX1.6 (PD)
/SA868/PTT: Q3.3 (D), TX1.5 (PTT)
/SA868/RF OUT: C4.1, L1.1, TX1.12 (ANT)
/SA868/RF_OUT_FILTERED: AE1.1 (A), C8.1, L3.2
/SA868/RXD 5V: Q2.3 (D), R5.2, TX1.16 (RXD)
/SA868/Radio UART RX: PI_HDR1.8 (GPIO14/TXD), Q2.2 (S), R3.2
/SA868/Radio UART TX: PI_HDR1.10 (GPIO15/RXD), Q1.2 (S), R2.2
/SA868/SQ: R7.1, TX1.1 (SQ)
/SA868/TXD 5V: Q1.3 (D), R4.2, TX1.17 (TXD)
/Sound Card/D+: J1.2, R12.2, R13.1
/Sound Card/D-: J1.1, R14.1
GND: AE1.2 (Shield), C1.1, C2.1, C3.1, C4.2, C6.2, C7.2, C8.2, C9.2, C12.2, C13.2, C14.2, C17.2, C18.2, C19.2, C20.2, C21.2, K1.2 (Cathode), PI_HDR1.6 (GND), PI_HDR1.9 (GND), PI_HDR1.14 (GND), PI_HDR1.20 (GND), PI_HDR1.25 (GND), PI_HDR1.30 (GND), PI_HDR1.34 (GND), PI_HDR1.39 (GND), Q3.2 (S), Q4.3 (E), R9.2, RV1.1, TX1.9 (GND), TX1.10 (GND), U1.4 (DGNDU), U1.11 (AGNDC), U1.18 (AGNDP), U1.22 (AGNDX), U1.26 (DGND), Y1.2, Y1.4
GPIO PTT: PI_HDR1.31 (GCLK2/GPIO6), R8.1
GPIO SQ: PI_HDR1.40 (GPIO21/SCLK1), Q4.2 (C), R10.2
unnamed: C5.1, RV1.3
unnamed: C6.1, L1.2, L2.1
unnamed: C7.1, L2.2, L3.1
unnamed: C9.1, R11.2, U1.3 (VBUS)
unnamed: C10.1, U1.12 (VINL)
unnamed: C11.1, U1.13 (VINR)
unnamed: C12.1, U1.10 (VCCCI)
unnamed: C13.1, U1.14 (VCOM)
unnamed: C14.1, U1.17 (VCCP1I)
unnamed: C15.1, U1.16 (VOUTL)
unnamed: C16.1, U1.15 (VOUTR)
unnamed: C17.1, R12.1, U1.8 (SEL0), U1.9 (SEL1), U1.27 (VDDI)
unnamed: C18.1, U1.23 (VCCXI)
unnamed: C19.1, R15.2, U1.21 (XTI), Y1.3
unnamed: C21.1, U1.19 (VCCP2I)
unnamed: K1.1 (Anode), R1.1
unnamed: Q3.1 (G), R8.2
unnamed: Q4.1 (B), R7.2, R9.1
unnamed: R13.2, U1.1 (D+)
unnamed: R14.2, U1.2 (D-)
unnamed: C20.1, R15.1, U1.20 (XTO), Y1.1
Radio Power Control: PI_HDR1.11 (GPIO17), R1.2
