joshua-jerred/Giraffe/hardware/giraffe_flight_computer/giraffe_flight_computer.kicad_pcb

## KiCad design hardware/giraffe_flight_computer/giraffe_flight_computer.kicad_pcb (2025-07-18)

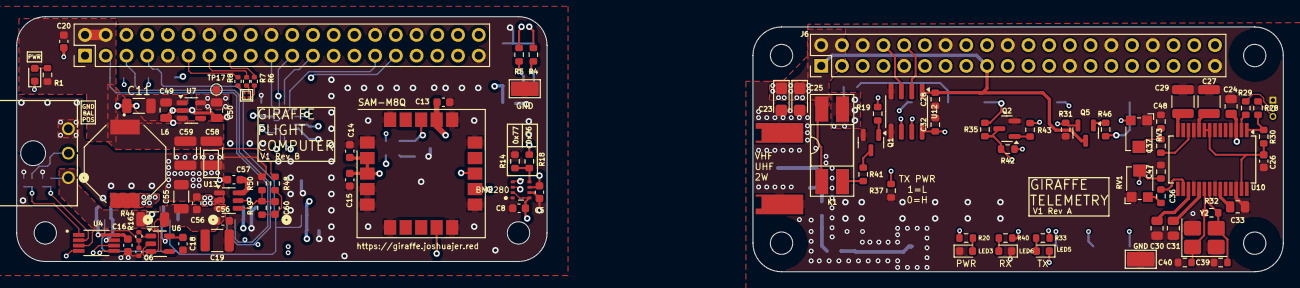
[picture p27: board giraffe_flight_computer.kicad_pcb from above]

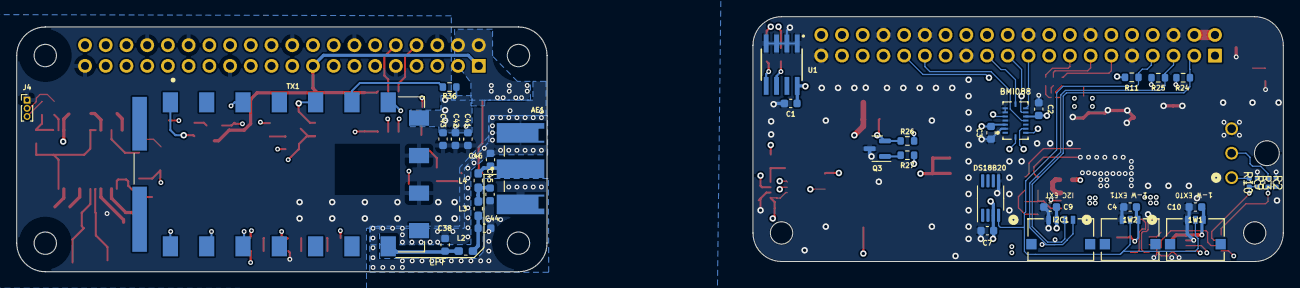
[picture p28: board giraffe_flight_computer.kicad_pcb from below]

Board: 4 copper layers, 155.2 x 31.3 mm, 129 parts (37 on the bottom side), 84 nets.

Parts:
1W1: 1W1; CONN_5037630000-SD_03_MOL
1W2: 1W2; CONN_5037630000-SD_03_MOL
AE1: ANT; MolexSmaConnector
C1, C2, C3, C4, C5, C7, C8, C9, C10, C13, C14, C15, C16, C18, C20, C41, C56, C56#2, C57: 0.1µF; C_0603_1608Metric
C6: C_Small; C_0402_1005Metric
C11: 10uf; C_1206_3216Metric
C19, C58, C59: 22µF; C_1210_3225Metric
C23, C25: 10μF; CP_EIA-3216-18_Kemet-A
C24, C31, C33: 1μF; R_0805_2012Metric
C26: 1μF; C_0603_1608Metric
C27, C29: 10μF; R_1210_3225Metric
C28, C32, C39, C40: 0.1μF; R_0603_1608Metric
C30: 1uF; R_0805_2012Metric
C36, C37: 1μF; R_0603_1608Metric
C38, C46: 20pF; C_0603_1608Metric
C42: 10kpF; C_0603_1608Metric
C43: 1kpF; C_0603_1608Metric
C44, C45: 36pF; C_0603_1608Metric
C47, C48: ?; R_0603_1608Metric
C49, C50: 1uf; C_0805_2012Metric
C55: 10µF; C_1206_3216Metric
C60: 75pf; C_0603_1608Metric
GND: GND; TestPoint_Keystone_5015_Micro-Minature
I2C1: I²C; CONN_5037630000-SD_04_MOL
J1: PI; pi_zero
J4: USB; PinHeader_1x03_P1.00mm_Vertical
J6: PI; SHOE_PCB
J7: Conn_01x03; CONN_SD-43650-001_03_MOL
K1: TLP241A; DIP-4_W8.89mm_SMDSocket_LongPads
L2, L4: 56nH; L_0603_1608Metric_Pad1.05x0.95mm_HandSolder
L3: 68nH; L_0603_1608Metric_Pad1.05x0.95mm_HandSolder
L6: 10uH; IND_SRU1048-100Y
LED1: SML-D12M8WT86; LED_0603_1608Metric
LED2: B36S3RGB-F6C0001HOU1930; B36S3RGB LED
LED3: PWR; LED_0603_1608Metric
LED5, LED6: LED_0603_1608Metric
Q1, Q2, Q5: BC847CT; SOT-23
Q3: NPN; SOT-23
R1: 56Ω; R_0603_1608Metric
R2, R3: ?; R_0402_1005Metric
R4, R5: 3.9kΩ; R_0603_1608Metric
R6: 270Ω; R_0402_1005Metric
R7, R8: 360Ω; R_0402_1005Metric
R9: 6.8k; R_0402_1005Metric
R10: 2.2k; R_0402_1005Metric
R11: 4.7kΩ; R_0603_1608Metric
R14, R18, R35, R36, R37: 0Ω; R_0603_1608Metric
R16: R_Small; R_0402_1005Metric
R19, R43: 50kΩ; R_0603_1608Metric
R20, R33: 150Ω; R_0603_1608Metric
R24, R25: *; R_0603_1608Metric
R26, R27: ?Ω; R_0603_1608Metric
R28, R29: 22Ω; R_0603_1608Metric
R30: 1.5kΩ; R_0603_1608Metric
R31, R42, R46: 5kΩ; R_0603_1608Metric
R32: 1MΩ; R_0603_1608Metric
R40: ?kΩ; R_0603_1608Metric
R41: 470Ω; R_0603_1608Metric
R44: 0.01Ω; R_1206_3216Metric
R48: 49; R_0603_1608Metric
R49: 100k; R_0603_1608Metric
R50: 13.3k; R_0603_1608Metric
RV1, RV3: 100k; Potentiometer_Bourns_TC33X_Vertical
TP3: GND; TestPoint_Keystone_5015_Micro-Minature
TP17: TestPoint; TestPoint_Pad_D1.0mm
TX1: SA868; DORJI_DRA818V
U1: CAT24C32; CAT24C32WI_GT3
U2: BMI088
U3: DS18B20; MSOP-8_3x3mm_P0.65mm
U4: MAX11613; SOP65P490X110-8N
U5: BME280
U6: INA180A3; SOT-23-5
U7: TLV75533PDBV; SOT-23-5
U8: SAM-M8Q; ublox_SAM-M8Q
U10: PCM2902C; SSOP-28_5.3x10.2mm_P0.65mm
U12: ISO6720B; SOIC-8_3.9x4.9mm_P1.27mm
U13: TPS54302; SOT-23-6
Y2: 12 MHz; Crystal_SMD_3225-4Pin_3.2x2.5mm_HandSoldering

Connections:
/hat/1_WIRE: 1W1.2, 1W2.2, J1.7 (GCLK0/GPIO4), R11.2, U3.4 (DQ)
/hat/+BATT: J7.1, R9.1, R44.1, U6.3 (+)
/hat/ADC.CH0: R2.2, R3.1, U4.1 (AIN0)
/hat/ADC.CH1: R9.2, R10.1, U4.2 (AIN1)
/hat/ADC.CH2: C6.1, R16.2, U4.3 (AIN2)
/hat/BAT_BALANCE: J7.2, R2.1
/hat/BAT_SENSED: C19.1, C55.1, C56.1, C56#2.1, R44.2, U6.4 (-), U13.3 (VIN)
/hat/BMI088.INT1: J1.31 (GCLK2/GPIO6), U2.16 (INT1)
/hat/BMI088.INT3: J1.29 (GCLK1/GPIO5), U2.12 (INT3)
/hat/EEPROM.SCL: J1.28 (ID_SC/GPIO1), R5.1, U1.6 (SCL)
/hat/EEPROM.SDA: J1.27 (ID_SD/GPIO0), R4.1, U1.5 (SDA)
/hat/I2C0.SCL: I2C1.4, J1.5 (SCL/GPIO3), R25.2, U4.5 (SCL), U5.4 (SCK), U8.12 (SCL)
/hat/I2C0.SDA: I2C1.3, J1.3 (SDA/GPIO2), R24.1, U4.6 (SDA), U5.3 (SDI), U8.9 (SDA)
/hat/SAM_M8Q.RST: J1.32 (PWM0/GPIO12), R27.2
/hat/SAM_M8Q.TX_RDY: J1.33 (PWM1/GPIO13), U8.13 (TXD)
/hat/SPI0.CE0: J1.24 (~CE0/GPIO8), U2.14 (CSB1)
/hat/SPI0.CE1: J1.26 (~CE1/GPIO7), U2.5 (CSB2)
/hat/SPI0.MISO: J1.21 (MISO0/GPIO9), U2.10 (SDO2), U2.15 (SDO1)
/hat/SPI0.MOSI: J1.19 (MOSI0/GPIO10), U2.9 (SDA/SDI)
/hat/SPI0.SCLK: J1.23 (SCLK0/GPIO11), U2.8 (SCL/SCK)
/hat/STATUS_LED.BLUE: J1.11 (GPIO17), R8.1
/hat/STATUS_LED.GREEN: J1.13 (GPIO27), R7.1
/hat/STATUS_LED.RED: J1.15 (GPIO22), R6.1
/shoe/AUDIO_IN_LEFT: C37.2, C48.1, RV3.2
/shoe/PI_GPIO_SA868_PTT: J6.18 (GPIO24), R43.1
/shoe/PI_GPIO_SA868_RX: J6.22 (GPIO25), Q5.2 (E), R31.1, R40.2
/shoe/PI_GPIO_SHOE_POWER_CONTROL: J6.16 (GPIO23), R19.1
/shoe/SA868 AUDIO_OUT: RV3.3, TX1.3 (AF_OUT)
/shoe/SA868 H/L: R37.2, TX1.7 (H/L)
/shoe/SA868 MIC_IN: C47.1, RV1.2, TX1.18 (MIC_IN)
/shoe/SA868 PTT: R35.2, TX1.5 (PTT)
/shoe/SA868 RF: C38.1, L2.1, TX1.12 (ANT)
/shoe/SA868 RX: R46.1, TX1.1 (SQ)
/shoe/SA868 UART RXD: TX1.16 (RXD), U12.6 (OUTB)
/shoe/SA868 UART TXD: TX1.17 (TXD), U12.7 (INA)
/shoe/S_5V_IN: C23.1, C25.1, J6.2 (5V), J6.4 (5V), K1.1 (Anode), K1.4 (Drain)
/shoe/UART.RX: J6.10 (GPIO15/RXD), U12.2 (OUTA)
/shoe/UART.TX: J6.8 (GPIO14/TXD), U12.3 (INB)
/shoe/USB Audio Codec/audio_codec_out_left: C36.2, RV1.3
H_3V3: 1W1.3, 1W2.3, C1.1, C2.2, C3.2, C4.2, C5.2, C7.2, C8.2, C9.2, C10.2, C13.1, C14.1, C15.1, C16.1, C18.1, C50.2, I2C1.2, R4.2, R5.2, R11.1, R18.2, R24.2, R25.1, R26.2, TP17.1, U1.8 (VCC), U2.3 (VDD), U2.11 (VDDIO), U3.3 (V_{DD}), U4.8 (Vdd), U5.2 (CSB), U5.6 (VDDIO), U5.8 (VDD), U6.5 (V+), U7.5 (OUT), U8.2 (VCC_IO), U8.3 (V_BCKP), U8.17 (VCC)
H_5V: C11.2, C20.2, C49.2, C58.1, C59.1, J1.2 (5V), J1.4 (5V), L6.1, R1.1, R48.1, U7.1 (IN), U7.3 (EN)
H_GND: 1W1.1, 1W2.1, C1.2, C2.1, C3.1, C4.1, C5.1, C6.2, C7.1, C8.1, C9.1, C10.1, C11.1, C13.2, C14.2, C15.2, C16.2, C18.2, C19.2, C20.1, C49.1, C50.1, C55.2, C56.2, C56#2.2, C58.2, C59.2, I2C1.1, J1.6 (GND), J1.9 (GND), J1.14 (GND), J1.20 (GND), J1.25 (GND), J1.30 (GND), J1.34 (GND), J1.39 (GND), J7.3, LED1.1 (K), LED2.4 (K), Q3.3 (E), R3.2, R10.2, R14.2, R50.2, TP3.1, U1.1 (A0), U1.2 (A1), U1.3 (A2), U1.4 (VSS), U2.2 (NC), U2.4 (GNDA), U2.6 (GNDIO), U2.7 (PS), U3.5 (GND), U4.7 (GND), U5.1 (GND), U5.7 (GND), U6.2 (GND), U7.2 (GND), U8.1 (GND), U8.4 (GND), U8.5 (GND), U8.6 (GND), U8.10 (GND), U8.11 (GND), U8.15 (GND), U8.16 (GND), U8.20 (GND), U13.1 (GND)
unnamed: AE1.1 (A), C46.1, L4.2
unnamed: C44.1, L2.2, L3.1
unnamed: C45.1, L3.2, L4.1
unnamed: C60.1, R48.2, R49.1
unnamed: J4.2, R29.1
unnamed: J4.3, R28.1
unnamed: K1.2 (Cathode), R41.1
unnamed: LED1.2 (A), R1.2
unnamed: LED2.3 (BA), R8.2
unnamed: LED2.2 (GA), R7.2
unnamed: LED2.1 (RA), R6.2
unnamed: LED3.2 (A), R20.2
unnamed: LED5.2 (A), R33.1
unnamed: LED5.1 (K), Q2.3 (C), R35.1, R42.2
unnamed: LED6.2 (A), R40.1
unnamed: Q1.1 (B), R19.2
unnamed: Q1.3 (C), R41.2
unnamed: Q2.1 (B), R43.2
unnamed: Q3.1 (B), R27.1
unnamed: Q3.2 (C), R26.1, U8.18 (~RESET)
unnamed: Q5.1 (B), R46.2
unnamed: R16.1, U6.1
unnamed: R36.1, TX1.6 (PD)
unnamed: R14.1, R18.1, U5.5 (SDO)
unnamed: R28.2, R30.2, U10.1 (D+)
unnamed: R29.2, U10.2 (D-)
unnamed: C26.2, R30.1, U10.8 (SEL0), U10.9 (SEL1), U10.27 (VDDI)
unnamed: C27.1, U10.10 (VCCCI)
unnamed: C30.2, U10.17 (VCCP1I)
unnamed: C31.2, U10.19 (VCCP2I)
unnamed: C33.2, U10.23 (VCCXI)
unnamed: C29.1, U10.14 (VCOM)
unnamed: C37.1, U10.12 (VINL)
unnamed: C36.1, U10.16 (VOUTL)
unnamed: C39.1, R32.2, U10.21 (XTI), Y2.3
unnamed: C40.1, R32.1, U10.20 (XTO), Y2.1
unnamed: C57.1, U13.6 (BOOT)
unnamed: C60.2, R49.2, R50.1, U13.4 (FB)
unnamed: C57.2, L6.2, U13.2 (SW)
S_3V3: C28.2, J6.1 (3V3), J6.17 (3V3), Q5.3 (C), U12.1 (VCC1)
S_5V: C24.1, C32.1, C41.2, C42.2, C43.2, K1.3 (Drain), R20.1, R33.2, R36.2, R42.1, TX1.8 (VBAT), U10.3 (VBUS), U12.8 (VCC2)
S_GND: AE1.2 (Shield), AE1.3 (Shield), AE1.4 (Shield), AE1.5 (Shield), C23.2, C24.2, C25.2, C26.1, C27.2, C28.1, C29.2, C30.1, C31.1, C32.2, C33.1, C38.2, C39.2, C40.2, C41.1, C42.1, C43.1, C44.2, C45.2, C46.2, C47.2, C48.2, GND.1, J4.1, J6.6 (GND), J6.9 (GND), J6.14 (GND), J6.20 (GND), J6.25 (GND), J6.30 (GND), J6.34 (GND), J6.39 (GND), LED3.1 (K), LED6.1 (K), Q1.2 (E), Q2.2 (E), R31.2, R37.1, RV1.1, RV3.1, TX1.9 (GND), TX1.10 (GND), U10.4 (DGNDU), U10.11 (AGNDC), U10.18 (AGNDP), U10.22 (AGNDX), U10.26 (DGND), U12.4 (GND1), U12.5 (GND2), Y2.2, Y2.4
