joshua-jerred/Giraffe/hardware/power_board/power_board.kicad_pcb

## KiCad design hardware/power_board/power_board.kicad_pcb (2025-07-18)

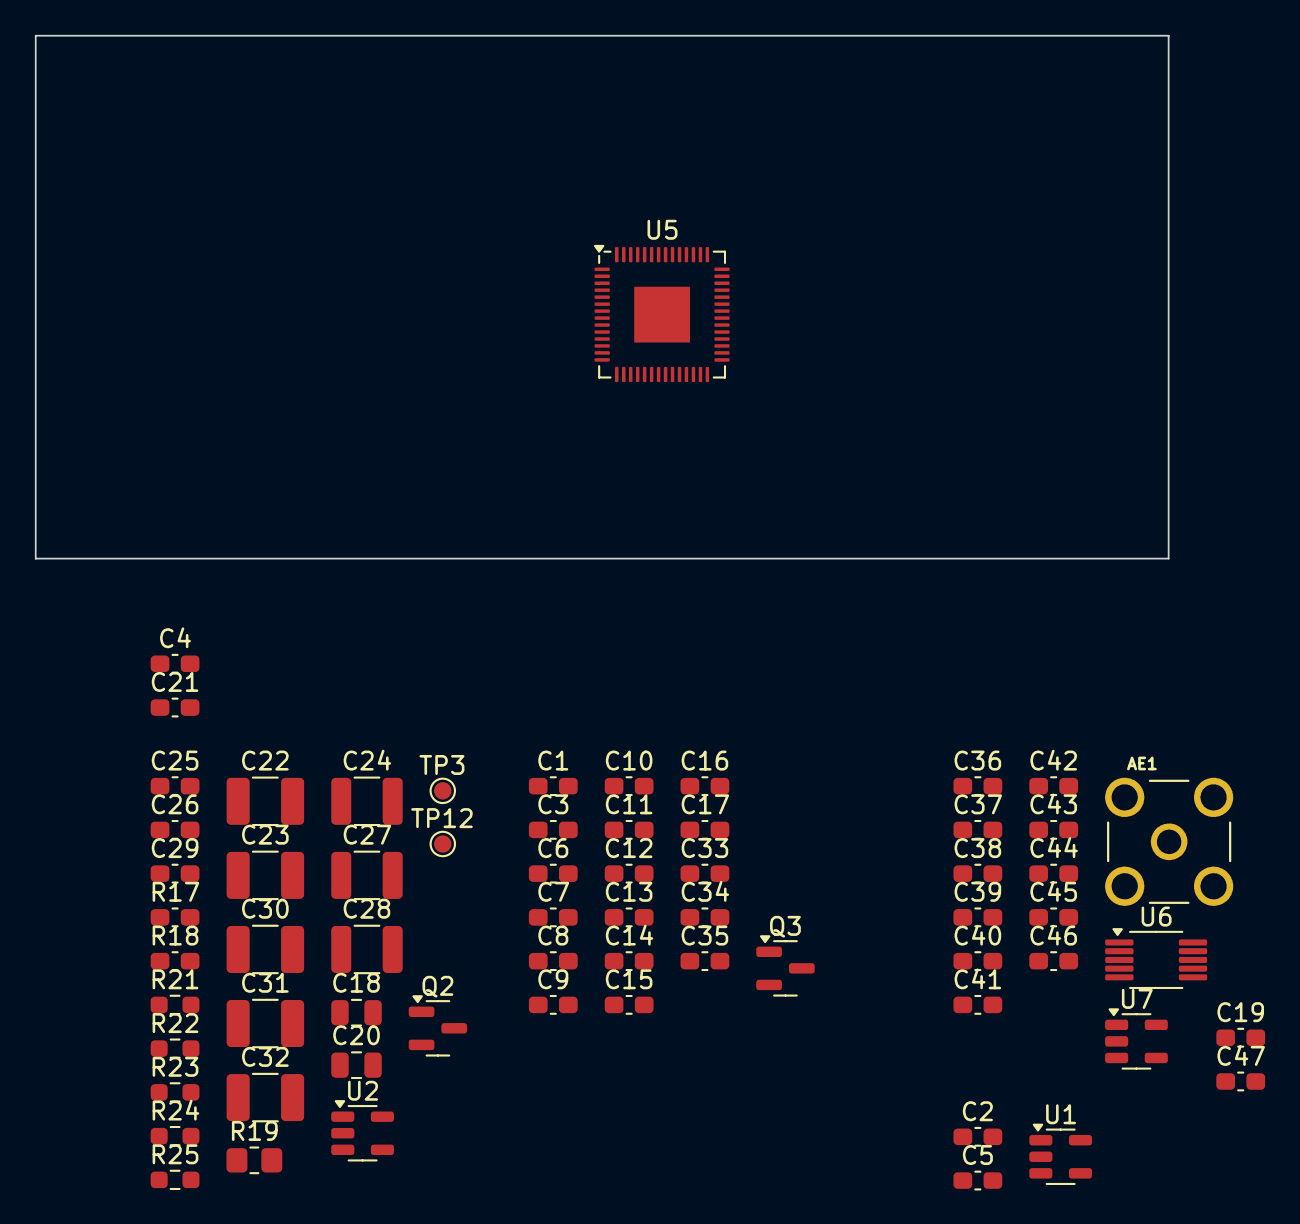
[picture p29: board power_board.kicad_pcb from above]

Board: 4 copper layers, 65.0 x 30.0 mm, 65 parts (0 on the bottom side), 26 nets, no tracks yet.

Parts:
AE1: LINX_CONSMA001-G
C1, C3: 15pf; C_0603_1608Metric_Pad1.08x0.95mm_HandSolder
C2, C6, C7, C8, C9, C10, C11, C14, C15, C19, C25, C26, C35, C36, C37: 0.1uf; C_0603_1608Metric_Pad1.08x0.95mm_HandSolder
C4, C5, C21, C40, C42, C43, C44, C45: ?; C_0603_1608Metric_Pad1.08x0.95mm_HandSolder
C12, C13, C33, C41, C46: 1uf; C_0603_1608Metric_Pad1.08x0.95mm_HandSolder
C16, C17: DNS; C_0603_1608Metric_Pad1.08x0.95mm_HandSolder
C18, C20: 1uf; C_0805_2012Metric
C22, C23, C30, C31, C32: DNS; C_1210_3225Metric_Pad1.33x2.70mm_HandSolder
C24: 10uf; C_1210_3225Metric
C27, C28: 22uf; C_1210_3225Metric
C29: 75pf; C_0603_1608Metric_Pad1.08x0.95mm_HandSolder
C34: 10uf; C_0603_1608Metric_Pad1.08x0.95mm_HandSolder
C38, C39: ?pf; C_0603_1608Metric_Pad1.08x0.95mm_HandSolder
C47: 2.2uf; C_0603_1608Metric_Pad1.08x0.95mm_HandSolder
Q2: MMBT3904LT1G; SOT-23
Q3: BC847CT; SOT-23
R17: 10k; C_0603_1608Metric_Pad1.08x0.95mm_HandSolder
R18: 1k; C_0603_1608Metric_Pad1.08x0.95mm_HandSolder
R19: 0; R_0805_2012Metric_Pad1.20x1.40mm_HandSolder
R21, R22: DNS; R_0603_1608Metric_Pad0.98x0.95mm_HandSolder
R23: 49; R_0603_1608Metric_Pad0.98x0.95mm_HandSolder
R24: 100k; R_0603_1608Metric_Pad0.98x0.95mm_HandSolder
R25: 13.3k; R_0603_1608Metric_Pad0.98x0.95mm_HandSolder
TP3, TP12: TestPoint; TestPoint_Pad_D1.0mm
U1: INA180A; SOT-23-5
U2: AP2112K-3.3; SOT-23-5
U5: RP2040; QFN-56-1EP_7x7mm_P0.4mm_EP3.2x3.2mm
U6: Si5351A-B-GT; MSOP-10_3x3mm_P0.5mm
U7: MIC2091-2YM5; SOT-23-5

Connections:
3V3_PICO: C6.2, C7.2, C8.2, C9.2, C10.2, C11.2, C12.2, C19.2, C33.2, C34.2, C35.2, C41.2, C46.2, C47.2, U5.1 (IOVDD), U5.10 (IOVDD), U5.22 (IOVDD), U5.33 (IOVDD), U5.42 (IOVDD), U5.43 (ADC_AVDD), U5.44 (VREG_IN), U5.48 (USB_VDD), U5.49 (IOVDD), U7.1 (VIN)
5V Primary: C18.1, R17.2, U2.1 (VIN)
5V_PRIMARY: C27.1, C28.1, C30.1, C31.1, C32.1, R23.1
+3V3_RP2040: C2.1, U1.5 (VS)
/Main Power Supply/3v3_en: Q2.1 (C), R17.1, TP3.1, U2.3 (EN)
/Main Power Supply/3v3_out: C20.1, R19.1, U2.5 (VOUT)
/Main Power Supply/+BATT_FILTERED: C22.1, C23.1, C24.1, C25.1, R21.2
/Main Power Supply/buck_enable: R21.1, R22.2, TP12.1
/Main Power Supply/buck_feedback: C29.2, R24.2, R25.1
/Power Input/battery_voltage_signal: C16.2, U5.40 (GPIO28_ADC2)
/Power Input/input_current_sense_signal: C17.2, U1.1 (OUT), U5.41 (GPIO29_ADC3)
/RP2040/2040_I2C0_WSPR.SCL: U5.16 (GPIO13), U6.4 (SCL)
/RP2040/2040_I2C0_WSPR.SDA: U5.15 (GPIO12), U6.5 (SDA)
/RP2040/+1V1_PICO_ADC_REF: C13.2, C14.2, C15.2, U5.23 (DVDD), U5.45 (VREG_VOUT), U5.50 (DVDD)
/RP2040/WSPR Transmitter/Si5351_3V3: C36.2, C37.2, U6.1 (VDD), U6.7 (VDDO), U7.5 (VOUT)
GND: C1.2, C2.2, C3.2, C6.1, C7.1, C8.1, C9.1, C10.1, C11.1, C12.1, C13.1, C14.1, C15.1, C16.1, C17.1, C18.2, C19.1, C20.2, C22.2, C23.2, C24.2, C25.2, C27.2, C28.2, C30.2, C31.2, C32.2, C33.1, C34.1, C35.1, C36.1, C37.1, C38.1, C39.1, C41.1, C42.1, C43.1, C44.1, C45.1, C46.1, C47.1, Q2.3 (E), Q3.2 (E), R22.1, R25.2, U1.2 (GND), U2.2 (GND), U5.19 (TESTEN), U5.57 (GND), U6.8 (GND), U7.2 (GND)
unnamed: AE1.1 (A), C45.2
unnamed: C29.1, R23.2, R24.1
unnamed: C40.1, C42.2
unnamed: Q2.2 (B), R18.1
unnamed: C5.2, U1.3 (IN+)
unnamed: C5.1, U1.4 (IN-)
unnamed: C1.1, U5.20 (XIN)
unnamed: C40.2, U6.10 (CLK0)
unnamed: C38.2, U6.2 (XA)
unnamed: C39.2, U6.3 (XB)
