joshua-jerred/Giraffe/hardware/Prototype Boards/5v Boost Supply/5v Power Supply.kicad_pcb

## KiCad design hardware/Prototype Boards/5v Boost Supply/5v Power Supply.kicad_pcb (2023-06-30)

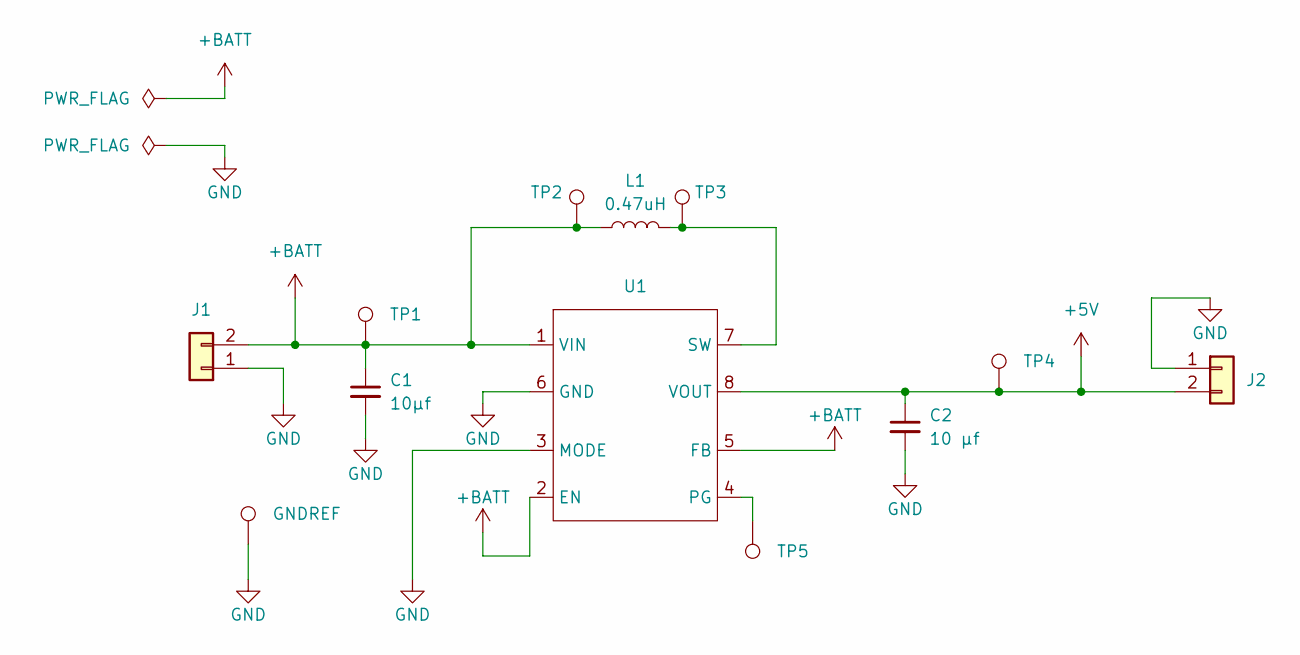
[picture p30: schematic 5v Power Supply.kicad_sch]

Parts:
C1: 10μf; C_1210_3225Metric
C2: 10 μf; C_1210_3225Metric
GNDREF: TestPoint_Keystone_5019_Minature
J1, J2: PinHeader_1x02_P2.54mm_Vertical
L1: 0.47uH; L_Coilcraft_XAL4020-XXX
TP1, TP2, TP3, TP4, TP5: TestPoint_Pad_D1.0mm
U1: SOT-583-8

Connections:
+5V: C2.1, J2.2, TP4.1, U1.8 (VOUT)
+BATT: C1.1, J1.2, L1.1, TP1.1, TP2.1, U1.1 (VIN), U1.2 (EN), U1.5 (FB)
GND: C1.2, C2.2, GNDREF.1, J1.1, J2.1, U1.3 (MODE), U1.6 (GND); also elsewhere on the board
unnamed: TP5.1, U1.4 (PG)
unnamed: L1.2, TP3.1, U1.7 (SW)

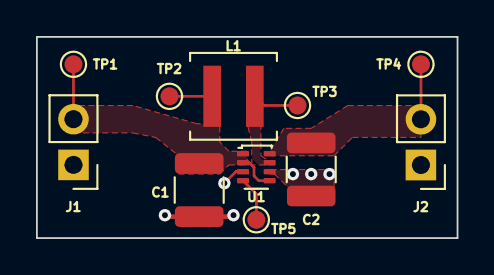
[picture p31: board 5v Power Supply.kicad_pcb from above]

Board: 2 copper layers, 23.4 x 11.2 mm, 12 parts (1 on the bottom side), 5 nets.

Other parts of the board:
GND: TestPoint_Keystone_5019_Minature

Their connections:
GND: GND.1; also elsewhere on the board
