joshua-jerred/Giraffe/hardware/Prototype Boards/5v Buck Supply/5v Buck Supply.kicad_pcb

## KiCad design hardware/Prototype Boards/5v Buck Supply/5v Buck Supply.kicad_pcb (2024-10-27, an earlier design)

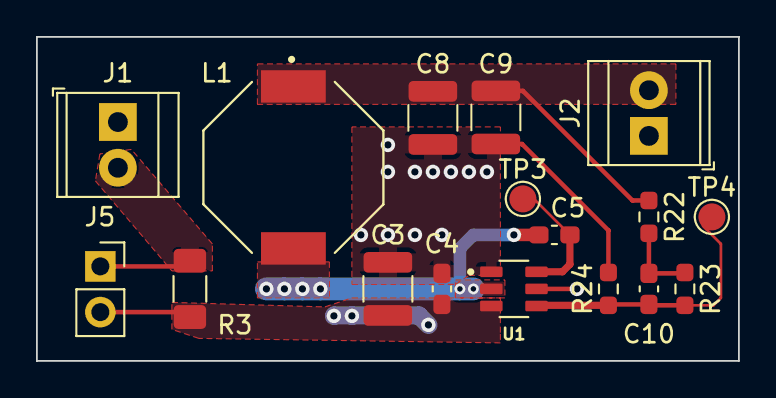
[picture p32: board hardware/Prototype Boards/5v Buck Supply/5v Buck Supply.kicad_pcb from above]

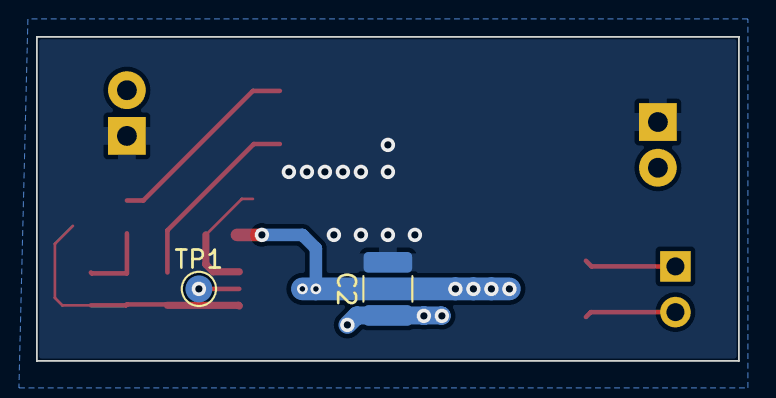
[picture p33: board hardware/Prototype Boards/5v Buck Supply/5v Buck Supply.kicad_pcb from below]

Board: 2 copper layers, 39.0 x 18.0 mm, 19 parts (2 on the bottom side), 9 nets.

Parts:
C2: DNS; C_1210_3225Metric
C3: 10uf; C_1210_3225Metric
C4, C5: 0.1uf; C_0603_1608Metric_Pad1.08x0.95mm_HandSolder
C8, C9: 22uf; C_1210_3225Metric
C10: 75pf; C_0603_1608Metric_Pad1.08x0.95mm_HandSolder
J1, J2: BATT; TerminalBlock_TE_282834-2_1x02_P2.54mm_Horizontal
J5: BATT_CURRENT; PinSocket_1x02_P2.54mm_Vertical
L1: 10uH; IND_SRU1048-100Y
R3: R_Shunt; C_1206_3216Metric_Pad1.33x1.80mm_HandSolder
R22: 49.9k; R_0603_1608Metric_Pad0.98x0.95mm_HandSolder
R23: 100k; R_0603_1608Metric_Pad0.98x0.95mm_HandSolder
R24: 13.3k; R_0603_1608Metric_Pad0.98x0.95mm_HandSolder
TP1: TestPoint; TestPoint_Pad_D1.5mm
TP3, TP4: TestPoint_Pad_D1.5mm
U1: TPS54302DDCR; SOT95P280X110-6N

Connections:
/bat in: J1.2, J5.1, R3.1
/buck_enable: TP1.1, U1.5 (EN)
/buck_feedback: C10.2, R23.2, R24.1, TP4.1, U1.4 (FB)
/sw: C5.2, L1.2, U1.2 (SW)
/vin: C2.1, C3.1, C4.1, J5.2, R3.2, U1.3 (VIN)
/vout: C8.1, C9.1, J2.2, L1.1, R22.1
GND: C2.2, C3.2, C4.2, C8.2, C9.2, J1.1, J2.1, R24.2, U1.1 (GND)
unnamed: C10.1, R22.2, R23.1
unnamed: C5.1, TP3.1, U1.6 (BOOT)
