joshua-jerred/Giraffe/hardware/Prototype Boards/DRA-818 Proto Board/DRA-818 Proto Board.kicad_pcb

## KiCad design hardware/Prototype Boards/DRA-818 Proto Board/DRA-818 Proto Board.kicad_pcb (2023-03-24)

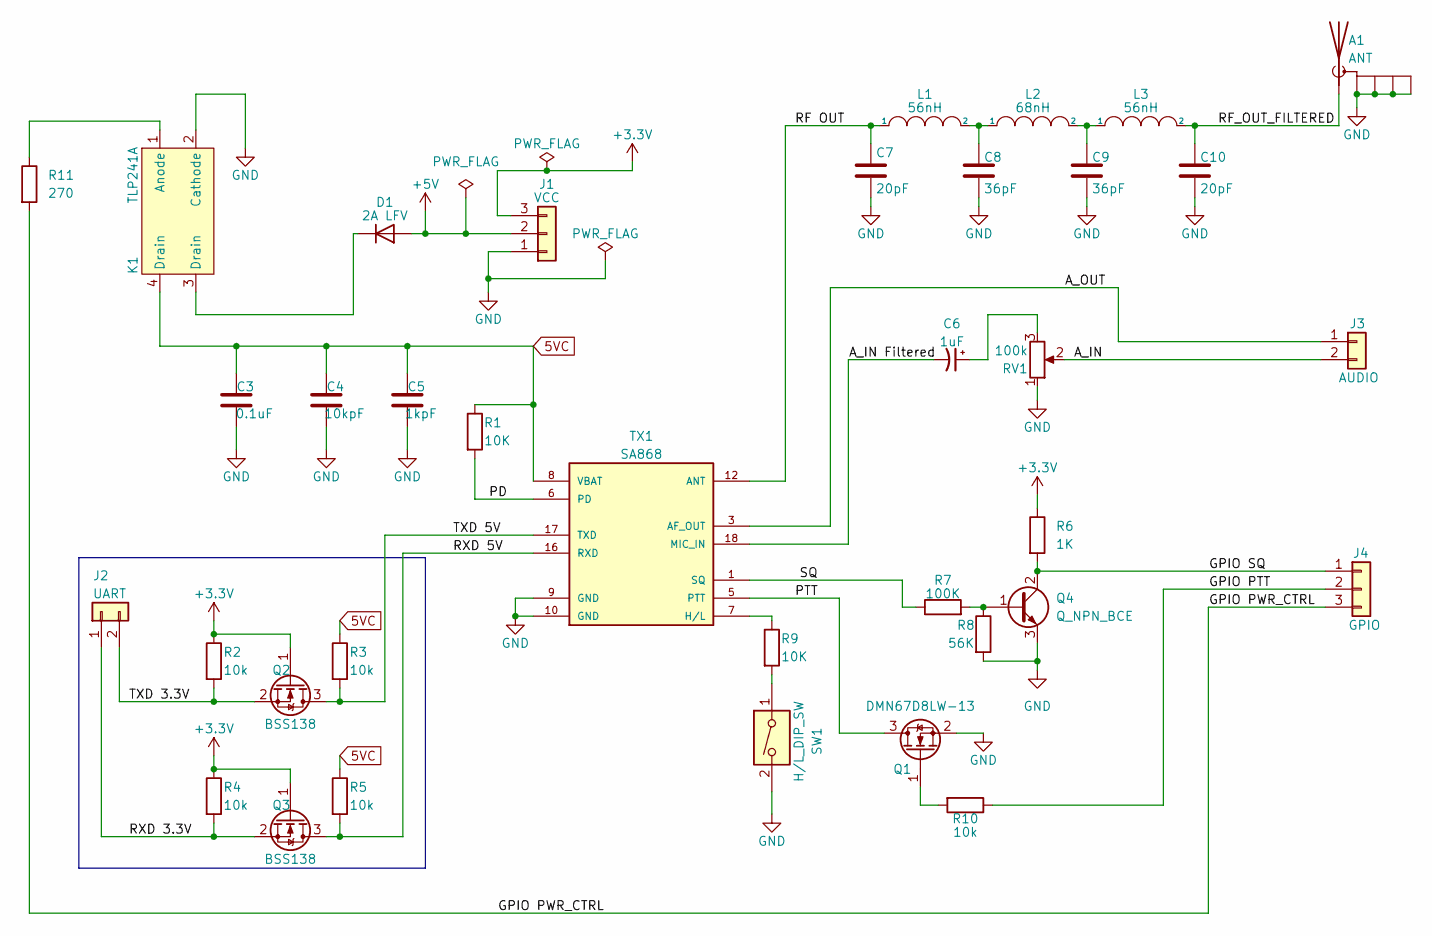
[picture p34: schematic DRA-818 Proto Board.kicad_sch]

Parts:
A1: ANT; LINX_CONSMA001-G
C3: 0.1uF; C_0603_1608Metric_Pad1.08x0.95mm_HandSolder
C4: 10kpF; C_0603_1608Metric_Pad1.08x0.95mm_HandSolder
C5: 1kpF; C_0603_1608Metric_Pad1.08x0.95mm_HandSolder
C6: 1uF; C_0805_2012Metric_Pad1.18x1.45mm_HandSolder
C7, C10: 20pF; C_0603_1608Metric_Pad1.08x0.95mm_HandSolder
C8, C9: 36pF; C_0603_1608Metric_Pad1.08x0.95mm_HandSolder
D1: 2A LFV; D_SMA
J1: VCC; PinHeader_1x03_P2.54mm_Vertical
J2: UART; PinHeader_1x02_P2.54mm_Vertical
J3: AUDIO; PinHeader_1x02_P2.54mm_Vertical
J4: GPIO; PinHeader_1x03_P2.54mm_Vertical
K1: TLP241A; DIP-4_W8.89mm_SMDSocket_LongPads
L1, L3: 56nH; IND_AIAC-1812-33NK-T
L2: 68nH; IND_AIAC-1812-33NK-T
Q1: DMN67D8LW-13; SOT-323_SC-70_Handsoldering
Q2, Q3: BSS138; SOT-23
Q4: Q_NPN_BCE; SOT-23
R1, R9: 10K; R_0603_1608Metric_Pad0.98x0.95mm_HandSolder
R2, R3, R4, R5, R10: 10k; R_0603_1608Metric_Pad0.98x0.95mm_HandSolder
R6: 1K; R_0603_1608Metric_Pad0.98x0.95mm_HandSolder
R7: 100K; R_0603_1608Metric_Pad0.98x0.95mm_HandSolder
R8: 56K; R_0603_1608Metric_Pad0.98x0.95mm_HandSolder
R11: 270; R_0603_1608Metric_Pad0.98x0.95mm_HandSolder
RV1: 100k; TRIM_3361P-1-104GLF
SW1: H/L_DIP_SW; SW_DIP_SPSTx01_Slide_6.7x4.1mm_W7.62mm_P2.54mm_LowProfile
TX1: SA868; DORJI_DRA818V; PART_REV 1.23; Digikey eBay

Connections:
5VC: C3.2, C4.2, C5.2, K1.4 (Drain), R1.1, R3.1, R5.1, TX1.8 (VBAT)
+3.3V: J1.3, Q2.1 (G), Q3.1 (G), R2.1, R4.1, R6.1
+5V: D1.2 (A), J1.2
/A_IN: J3.2, RV1.2
/A_IN Filtered: C6.2, TX1.18 (MIC_IN)
/A_OUT: J3.1, TX1.3 (AF_OUT)
/GPIO PTT: J4.2, R10.1
/GPIO PWR_CTRL: J4.3, R11.2
/GPIO SQ: J4.1, Q4.2 (C), R6.2
/PD: R1.2, TX1.6 (PD)
/PTT: Q1.3 (D), TX1.5 (PTT)
/RF OUT: C7.1, L1.1, TX1.12 (ANT)
/RF_OUT_FILTERED: A1.1 (A), C10.1, L3.2
/RXD 3.3V: J2.1, Q3.2 (S), R4.2
/RXD 5V: Q3.3 (D), R5.2, TX1.16 (RXD)
/SQ: R7.1, TX1.1 (SQ)
/TXD 3.3V: J2.2, Q2.2 (S), R2.2
/TXD 5V: Q2.3 (D), R3.2, TX1.17 (TXD)
GND: A1.S1 (Shield), A1.S2 (Shield), A1.S3 (Shield), A1.S4 (Shield), C3.1, C4.1, C5.1, C7.2, C8.2, C9.2, C10.2, J1.1, K1.2 (Cathode), Q1.2 (S), Q4.3 (E), R8.2, RV1.1, SW1.2, TX1.9 (GND), TX1.10 (GND)
unnamed: C6.1, RV1.3
unnamed: C8.1, L1.2, L2.1
unnamed: C9.1, L2.2, L3.1
unnamed: D1.1 (K), K1.3 (Drain)
unnamed: K1.1 (Anode), R11.1
unnamed: Q1.1 (G), R10.2
unnamed: Q4.1 (B), R7.2, R8.1
unnamed: R9.1, TX1.7 (H/L)
unnamed: R9.2, SW1.1

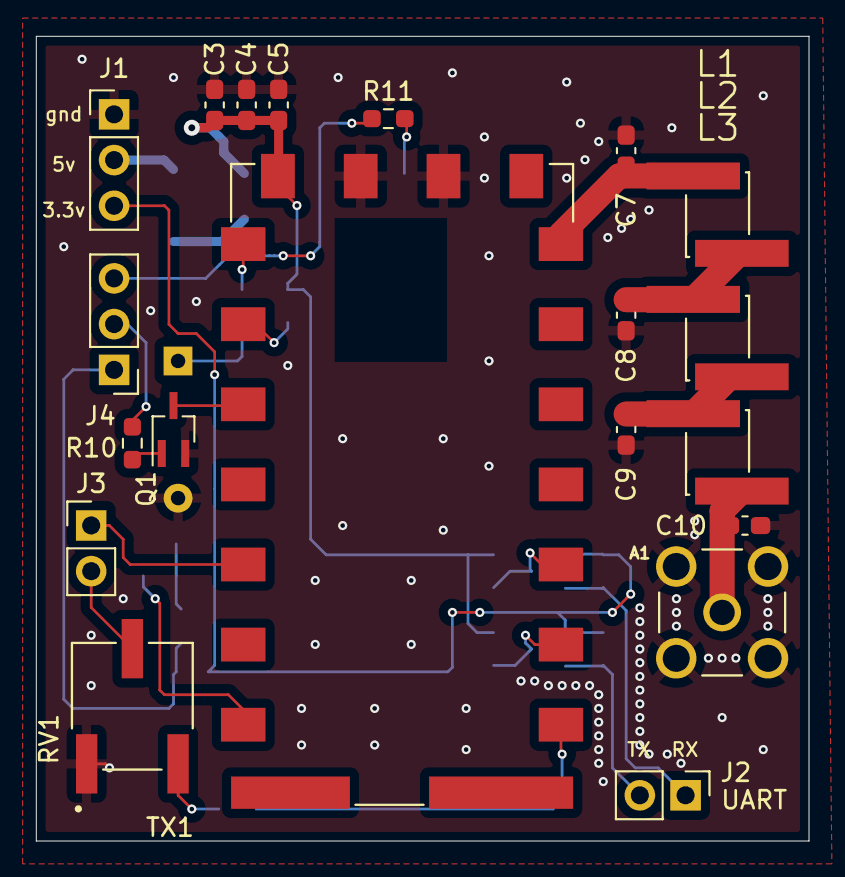
[picture p35: board DRA-818 Proto Board.kicad_pcb from above]

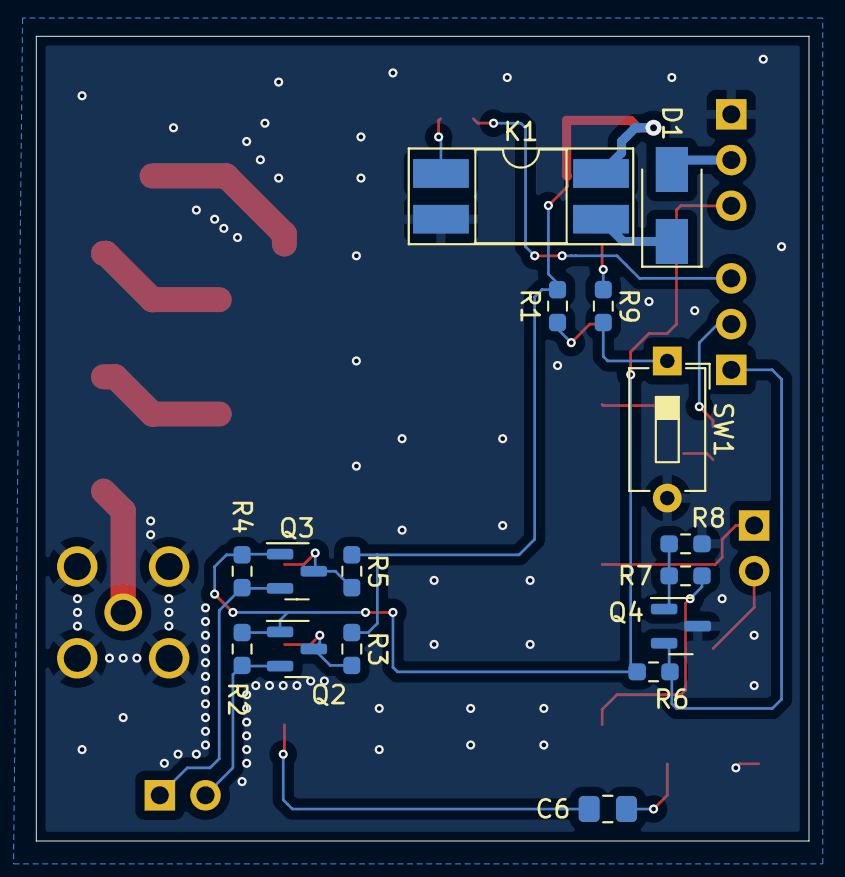
[picture p36: board DRA-818 Proto Board.kicad_pcb from below]

Board: 2 copper layers, 42.9 x 44.7 mm, 36 parts (16 on the bottom side), 28 nets.
