joshua-jerred/Giraffe/hardware/Prototype Boards/BME280 Proto Board/BME280 Proto Board.kicad_pcb

## KiCad design hardware/Prototype Boards/BME280 Proto Board/BME280 Proto Board.kicad_pcb (2022-12-17)

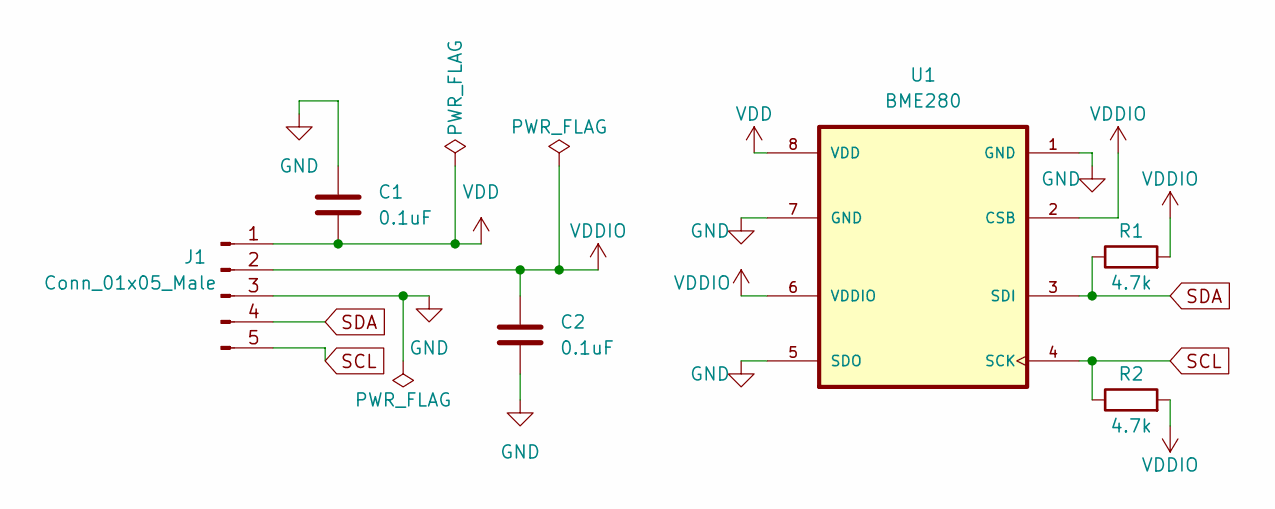
[picture p37: schematic BME280 Proto Board.kicad_sch]

Parts:
C1, C2: 0.1uF; C_0603_1608Metric_Pad1.08x0.95mm_HandSolder
J1: Conn_01x05_Male; PinHeader_1x05_P2.54mm_Horizontal
R1, R2: 4.7k; R_0603_1608Metric_Pad0.98x0.95mm_HandSolder
U1: BME280; PSON65P250X250X100-8N

Connections:
GND: C1.1, C2.2, J1.3, U1.1 (GND), U1.5 (SDO), U1.7 (GND)
SCL: J1.5, R2.1, U1.4 (SCK)
SDA: J1.4, R1.1, U1.3 (SDI)
VDD: C1.2, J1.1, U1.8 (VDD)
VDDF: C2.1, J1.2, R1.2, R2.2, U1.2 (CSB), U1.6 (VDDIO)

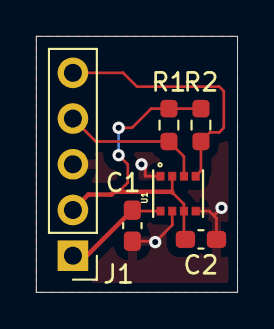
[picture p38: board BME280 Proto Board.kicad_pcb from above]

Board: 2 copper layers, 11.2 x 14.2 mm, 6 parts (0 on the bottom side), 5 nets.
