joshua-jerred/Giraffe/hardware/Prototype Boards/PCM2902C Proto Board/PCM2902C Proto Board.kicad_pcb

## KiCad design hardware/Prototype Boards/PCM2902C Proto Board/PCM2902C Proto Board.kicad_pcb (2023-01-07)

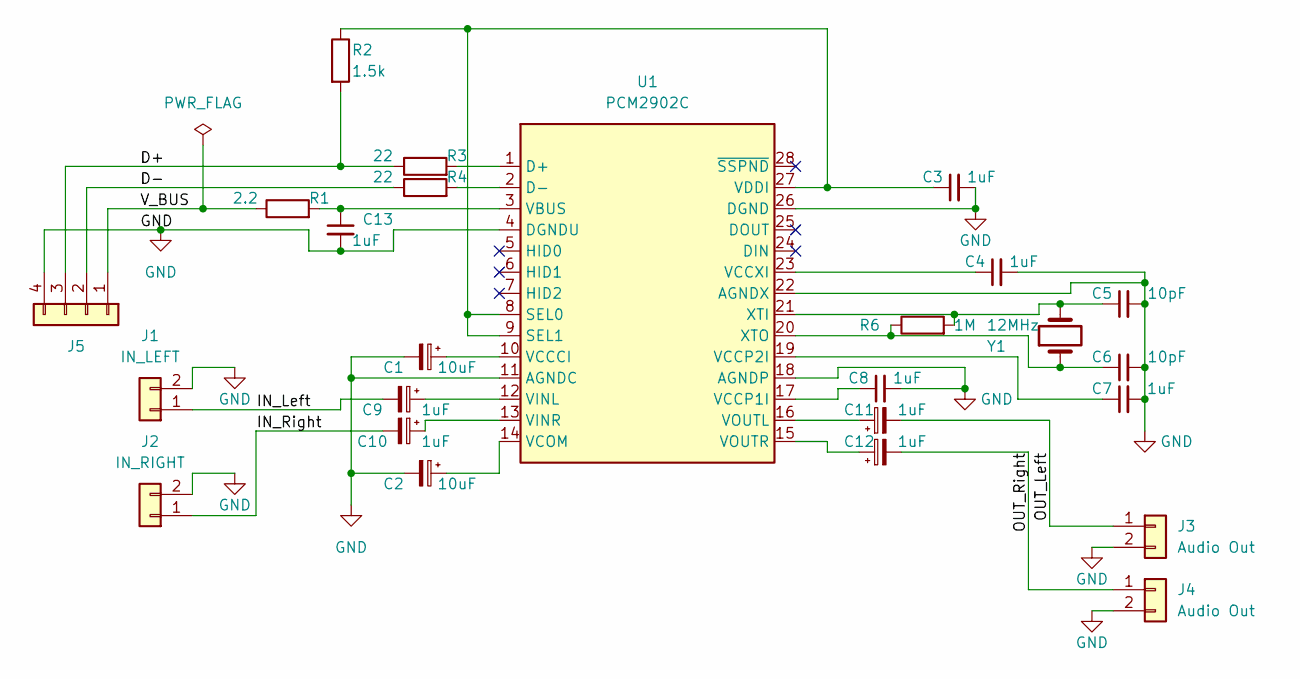
[picture p39: schematic PCM2902C Proto Board.kicad_sch]

Parts:
C1, C2: 10uF; C_1210_3225Metric_Pad1.33x2.70mm_HandSolder
C3, C4, C7, C8, C9, C10, C11, C12, C13: 1uF; C_0805_2012Metric_Pad1.18x1.45mm_HandSolder
C5, C6: 10pF; C_0603_1608Metric_Pad1.08x0.95mm_HandSolder
J1: IN_LEFT; PinHeader_1x02_P2.54mm_Vertical; Digikey N/A
J2: IN_RIGHT; PinHeader_1x02_P2.54mm_Vertical; Digikey N/A
J3, J4: Audio Out; PinHeader_1x02_P2.54mm_Vertical; Digikey N/A
J5: USB; PinHeader_1x04_P2.54mm_Vertical; Digikey N/A
R1: 2.2; C_0603_1608Metric_Pad1.08x0.95mm_HandSolder
R2: 1.5k; C_0603_1608Metric_Pad1.08x0.95mm_HandSolder
R3, R4: 22; C_0603_1608Metric_Pad1.08x0.95mm_HandSolder
R6: 1M; C_0603_1608Metric_Pad1.08x0.95mm_HandSolder
U1: PCM2902C; SSOP-28_5.3x10.2mm_P0.65mm; Digikey TI
Y1: 12MHz; Crystal_SMD_HC49-SD_HandSoldering

Connections:
/D+: J5.3, R2.2, R3.1
/D-: J5.2, R4.1
/IN_Left: C9.2, J1.1
/IN_Right: C10.2, J2.1
/OUT_Left: C11.2, J3.1
/OUT_Right: C12.2, J4.1
/V_BUS: J5.1, R1.1
GND: C1.2, C2.2, C3.2, C4.2, C5.2, C6.2, C7.2, C8.2, C13.2, J1.2, J2.2, J3.2, J4.2, J5.4, U1.4 (DGNDU), U1.11 (AGNDC), U1.18 (AGNDP), U1.22 (AGNDX), U1.26 (DGND)
unnamed: C1.1, U1.10 (VCCCI)
unnamed: C2.1, U1.14 (VCOM)
unnamed: C3.1, R2.1, U1.8 (SEL0), U1.9 (SEL1), U1.27 (VDDI)
unnamed: C4.1, U1.23 (VCCXI)
unnamed: C5.1, R6.2, U1.21 (XTI), Y1.2
unnamed: C6.1, R6.1, U1.20 (XTO), Y1.1
unnamed: C7.1, U1.19 (VCCP2I)
unnamed: C8.1, U1.17 (VCCP1I)
unnamed: C9.1, U1.12 (VINL)
unnamed: C10.1, U1.13 (VINR)
unnamed: C11.1, U1.16 (VOUTL)
unnamed: C12.1, U1.15 (VOUTR)
unnamed: C13.1, R1.2, U1.3 (VBUS)
unnamed: R3.2, U1.1 (D+)
unnamed: R4.2, U1.2 (D-)

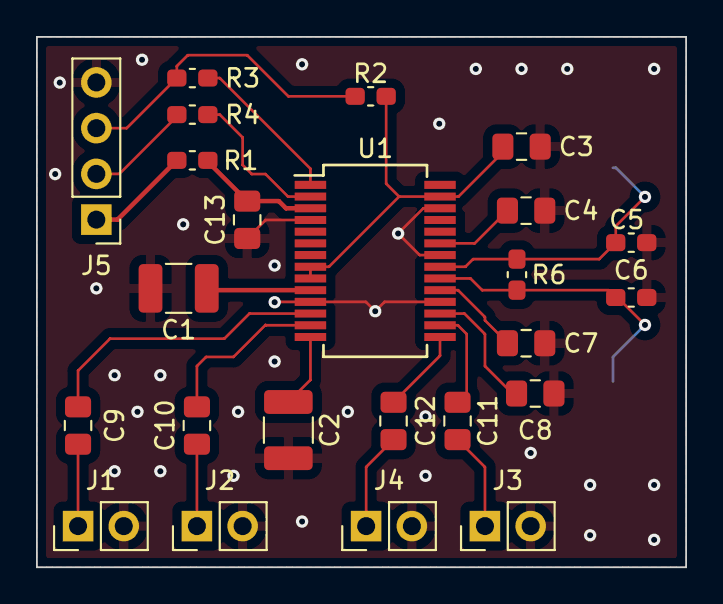
[picture p40: board PCM2902C Proto Board.kicad_pcb from above]

Board: 2 copper layers, 36.1 x 29.5 mm, 25 parts (1 on the bottom side), 23 nets.
