joshua-jerred/Giraffe/src/flight_system/shared_data/blocks.hpp

#ifndef BLOCKS_HPP_
#define BLOCKS_HPP_

#include <mutex>

#include <BoosterSeat/clock.hpp>
#include <BoosterSeat/numbers.hpp>
#include <BoosterSeat/time.hpp>

#include "blocks.hpp"
#include "json.hpp"
#include "node.hpp"
#include "positional.hpp"

namespace data {
inline auto rnd = bst::doubleToPrecisionTwo;

namespace blocks {
/**
 * @brief Simple Struct Container with a mutex.
 * The struct must have a valid default constructor.
 */
template <class T> class Block {
public:
  void set(T data) {
    std::lock_guard<std::mutex> lock(mutex_);
    data_ = data;
    last_updated_ = bst::clck::now();
  }

  T get() {
    std::lock_guard<std::mutex> lock(mutex_);
    return data_;
  }

  int getAgeMs() {
    std::lock_guard<std::mutex> lock(mutex_);
    return bst::clck::millisecondsElapsed(last_updated_);
  }

  int getAgeSec() {
    std::lock_guard<std::mutex> lock(mutex_);
    return bst::clck::secondsElapsed(last_updated_);
  }

private:
  std::mutex mutex_ = std::mutex();
  T data_ = T(); // Must have default constructor
  bst::clck::TimePoint last_updated_ = bst::clck::now();
};

/**
 * @todo implement this
 */
struct ConfigurationStats { // Set by the data module
  int load_errors = 0;
  int save_errors = 0;

  Json toJson() const {
    Json json_data;
    json_data["load_errors"] = load_errors;
    json_data["save_errors"] = save_errors;
    return json_data;
  }
};

/**
 * @brief Struct containing the status of each module.
 */
struct ModulesStatuses { // Set by the data module
  node::Status data = node::Status::UNKNOWN;
  node::Status console = node::Status::UNKNOWN;
  node::Status server = node::Status::UNKNOWN;
  node::Status system = node::Status::UNKNOWN;
  node::Status extension = node::Status::UNKNOWN;
  node::Status telemetry = node::Status::UNKNOWN;

  Json toJson() const {
    Json json_data;
    json_data["data"] = node::K_STATUS_TO_STRING_MAP.at(data);
    json_data["console"] = node::K_STATUS_TO_STRING_MAP.at(console);
    json_data["server"] = node::K_STATUS_TO_STRING_MAP.at(server);
    json_data["system"] = node::K_STATUS_TO_STRING_MAP.at(system);
    json_data["extension"] = node::K_STATUS_TO_STRING_MAP.at(extension);
    json_data["telemetry"] = node::K_STATUS_TO_STRING_MAP.at(telemetry);
    return json_data;
  }
};

/**
 * @todo implement this
 */
struct ServerModuleStats { // Set by the server module
  int num_messages_received = 0;
  int num_invalid_received = 0;
  double bytes_per_second_down = 0.0;
  double bytes_per_second_up = 0.0;
  bool is_connected = false;

  Json toJson() {
    Json json_data;
    json_data["num_messages_received"] = num_messages_received;
    json_data["num_invalid_received"] = num_invalid_received;
    json_data["bytes_per_second_down"] = rnd(bytes_per_second_down);
    json_data["bytes_per_second_up"] = rnd(bytes_per_second_up);
    json_data["connection_status"] = is_connected;
    return json_data;
  }
};

/**
 * @brief Struct containing statistics about the data and log streams.
 */
struct StreamsStats { // Set by the data module
  struct StreamStats {
    int current_packets = 0;
    int total_packets = 0;
    int processing_delay_ms = 0;
  };

  StreamStats data = StreamStats();
  StreamStats log = StreamStats();
  StreamStats gps = StreamStats();
  StreamStats imu = StreamStats();
  StreamStats command = StreamStats();

  Json toJson() {
    Json json_data;
    json_data["data_current_packets"] = data.current_packets;
    json_data["data_total_packets"] = data.total_packets;
    json_data["data_processing_delay_ms"] = data.processing_delay_ms;
    json_data["log_current_packets"] = log.current_packets;
    json_data["log_total_packets"] = log.total_packets;
    json_data["log_processing_delay_ms"] = log.processing_delay_ms;
    json_data["gps_current_packets"] = gps.current_packets;
    json_data["gps_total_packets"] = gps.total_packets;
    json_data["gps_processing_delay_ms"] = gps.processing_delay_ms;
    json_data["imu_current_packets"] = imu.current_packets;
    json_data["imu_total_packets"] = imu.total_packets;
    json_data["imu_processing_delay_ms"] = imu.processing_delay_ms;
    return json_data;
  }
};

/**
 * @brief Struct containing statistics about the data file log.
 */
struct DataLogStats {
  typedef double FileSizeType;

  // Data Files
  bool data_dir = false;
  bool data_archive_dir = false;
  bool data_file = false;

  FileSizeType data_file_size = 0.0;
  FileSizeType data_archive_dir_size = 0.0;
  std::string data_file_path{};

  // Log Files
  bool log_dir = false;
  bool log_archive_dir = false;
  bool log_file = false;

  FileSizeType log_file_size = 0.0;
  FileSizeType log_archive_dir_size = 0.0;
  std::string log_file_path{};

  std::vector<std::string> archived_data_files_list{};
  std::vector<std::string> archived_log_files_list{};

  Json toJson() {
    Json json_data;
    json_data["data_dir"] = data_dir;
    json_data["data_archive_dir"] = data_archive_dir;
    json_data["data_file"] = data_file;
    json_data["data_file_size"] = rnd(data_file_size);
    json_data["data_dir_size"] = rnd(data_archive_dir_size);
    json_data["data_file_path"] = data_file_path;
    json_data["log_dir"] = log_dir;
    json_data["log_archive_dir"] = log_archive_dir;
    json_data["log_file"] = log_file;
    json_data["log_file_size"] = rnd(log_file_size);
    json_data["log_archive_dir_size"] = rnd(log_archive_dir_size);
    json_data["log_file_path"] = log_file_path;
    json_data["archived_data_files_list"] = archived_data_files_list;
    json_data["archived_log_files_list"] = archived_log_files_list;
    return json_data;
  }
};

struct FileSystemData {
  bool giraffe_directory_valid = false;
  std::string giraffe_directory_path = "";

  bool gfs_image_dir_valid = false;
  std::string gfs_image_dir_path = "";
  uint32_t gfs_image_dir_file_count = 0;
  std::vector<std::string> gfs_image_files = {};

  Json toJson() {
    Json json_data;
    json_data["giraffe_directory_valid"] = giraffe_directory_valid;
    json_data["giraffe_directory_path"] = giraffe_directory_path;
    json_data["gfs_image_dir_valid"] = gfs_image_dir_valid;
    json_data["gfs_image_dir_path"] = gfs_image_dir_path;
    json_data["gfs_image_dir_file_count"] = gfs_image_dir_file_count;
    json_data["gfs_image_files"] = gfs_image_files;
    return json_data;
  }
};

/**
 * @brief Struct containing system information related to the system module.
 */
struct SystemInfo { // Set by the system module
  // misc
  float uptime_hours = 0.0;

  // cpu
  float cpu_load_avg_1 = 0.0;  // 1 minute
  float cpu_load_avg_5 = 0.0;  // 5 minutes
  float cpu_load_avg_15 = 0.0; // 15 minutes
  float cpu_temp_c = 0.0;

  // mem
  float mem_total_gb = 0.0;
  float mem_free_gb = 0.0;
  float mem_used_percent = 0.0;

  // swap
  float swap_total_gb = 0.0;
  float swap_free_gb = 0.0;
  float swap_used_percent = 0.0;

  // disk
  float disk_total_gb = 0.0;
  float disk_free_gb = 0.0;
  float disk_used_percent = 0.0;

  // network (tbd)

  Json toJson() {
    Json json_data;
    json_data["uptime_hours"] = rnd(uptime_hours);
    json_data["cpu_load_avg_1"] = rnd(cpu_load_avg_1);
    json_data["cpu_load_avg_5"] = rnd(cpu_load_avg_5);
    json_data["cpu_load_avg_15"] = rnd(cpu_load_avg_15);
    json_data["cpu_temp_c"] = rnd(cpu_temp_c);
    json_data["mem_total_gb"] = rnd(mem_total_gb);
    json_data["mem_free_gb"] = rnd(mem_free_gb);
    json_data["mem_used_percent"] = rnd(mem_used_percent);
    json_data["swap_total_gb"] = rnd(swap_total_gb);
    json_data["swap_free_gb"] = rnd(swap_free_gb);
    json_data["swap_used_percent"] = rnd(swap_used_percent);
    json_data["disk_total_gb"] = rnd(disk_total_gb);
    json_data["disk_free_gb"] = rnd(disk_free_gb);
    json_data["disk_used_percent"] = rnd(disk_used_percent);
    return json_data;
  }
};

/**
 * @brief Struct containing statistics about the extension module and its
 * extensions.
 */
struct ExtensionModuleStats {
  /**
   * @brief The number of extensions that are in the configuration.
   */
  int num_configured = 0;
  int num_active = 0;
  int num_inactive = 0;

  struct ExtensionStatus {
    /// @brief The user defined name of the extension.
    std::string name;

    /// @brief The 'control' status of the extension. This is the extension
    /// module's label for the 'real' status.
    /// @see modules::ExtensionModule::ExtAction
    std::string control_status;

    /// @brief The status of the extension, as reported by the extension.
    node::Status internal_status;
  };

  /// @brief A vector mapping the extension name to its status.
  std::vector<ExtensionStatus> extension_statuses{};

  Json toJson() {
    Json json_data;
    json_data["num_configured"] = num_configured;
    json_data["num_active"] = num_active;
    json_data["num_inactive"] = num_inactive;

    Json extensions_json;
    for (const auto &ext : extension_statuses) {
      Json extension_data = {
          {"control_status", ext.control_status},
          {"internal_status",
           node::K_STATUS_TO_STRING_MAP.at(ext.internal_status)}};

      extensions_json[ext.name] = extension_data;
    }
    json_data["extension"] = extensions_json;
    return json_data;
  }
};

/**
 * @brief Struct containing location data (gps).
 */
struct LocationData {
  /**
   * @brief Whether or not we have a gps source.
   * @details Set to true if we have had a single gps frame come through the
   * stream.
   */
  bool have_gps_source = false;

  /**
   * @brief The current gps fix.
   */
  data::GpsFix current_gps_fix = data::GpsFix::NO_FIX;

  /**
   * @brief The last valid gps fix. If it is NO_FIX, there never was a valid
   * fix.
   */
  data::GpsFix last_valid_gps_fix = data::GpsFix::NO_FIX;

  /**
   * @brief The last valid gps fix.
   */
  data::GpsFrame last_valid_gps_frame{};

  /**
   * @brief The most recent gps frame.
   */
  data::GpsFrame last_gps_frame{};
};

void to_json(json &j, const LocationData &frame);

struct ImuData {
  /**
   * @brief Whether or not we have an imu source.
   * @details Set to true if we have had a single imu frame comes through the
   * stream.
   */
  bool have_imu_source = false;

  /**
   * @brief The most recent imu frame.
   */
  data::ImuFrame most_recent_imu_frame{};

  /**
   * @brief Last valid imu frame.
   */
  data::ImuFrame last_valid_imu_frame{};
};

/**
 * @brief Struct containing image data from a camera.
 */
struct CameraImages {
  bool have_camera_source = false;
  std::string last_valid_image_path = "";
  int num_images = 0;
};

struct TelemetryModuleStats {
  size_t exchange_queue_size = 0;
  size_t broadcast_queue_size = 0;
  size_t received_queue_size = 0;
  bool downlink_connected = false;
  uint64_t network_layer_latency_ms = 0;
  double volume = 0.0;
  double signal_to_noise_ratio = 0.0;
  double rssi = 0.0;
  uint32_t total_packets_received = 0;
  uint32_t total_packets_sent = 0;
  uint32_t total_messages_received = 0;
  uint32_t total_messages_sent = 0;
  uint32_t total_messages_dropped = 0;
  std::string last_received_message{};

  Json toJson() {
    Json json_data;
    json_data["exchange_queue_size"] = exchange_queue_size;
    json_data["broadcast_queue_size"] = broadcast_queue_size;
    json_data["received_queue_size"] = received_queue_size;
    json_data["downlink_connected"] = downlink_connected;
    json_data["network_layer_latency_ms"] = network_layer_latency_ms;
    json_data["volume"] = rnd(volume);
    json_data["signal_to_noise_ratio"] = rnd(signal_to_noise_ratio);
    json_data["rssi"] = rnd(rssi);
    json_data["total_packets_received"] = total_packets_received;
    json_data["total_packets_sent"] = total_packets_sent;

    json_data["last_received_message"] = last_received_message;

    return json_data;
  }
};

/**
 * @brief Data that is calculated from other data.
 */
struct CalculatedData {
  double battery_voltage_mv = 0.0;
  bool battery_voltage_mv_valid = false;

  double battery_current_ma = 0.0;
  bool battery_current_ma_valid = false;

  double battery_usage_mah = 0.0;
  bool battery_usage_mah_valid = false;

  /// @brief The estimated state of charge of the battery.
  /// @details Ranges from -100% to 100% (-100, 100), where 100% is fully
  /// charged, 0% is empty, and -100% is 200% discharged.
  int32_t battery_state_of_charge = 0.0;
  bool battery_state_of_charge_valid = false;

  double external_temperature_c = 0.0;
  bool external_temperature_valid = false;

  double relative_humidity = 0.0;
  bool relative_humidity_valid = false;

  /// @brief The best source for reliable barometric pressure data. If marked as
  /// valid, it should be trusted.
  double barometric_pressure_mbar = 0.0;
  /// @brief The validity flag for barometric_pressure_mbar.
  bool barometric_pressure_valid = false;

  int32_t pressure_altitude_m = 0;
  bool pressure_altitude_valid = false;

  /// @brief The vertical speed in meters per second from the pressure sensor.
  int32_t pressure_vertical_speed = 0;
  bool pressure_vertical_speed_valid = false;

  int32_t pressure_vertical_speed_mps_1min = 0;
  bool pressure_vertical_speed_1min_valid = false;

  int32_t distance_traveled_m = 0;
  bool distance_traveled_valid = false;

  int32_t distance_from_launch_m = 0;
  bool distance_from_launch_valid = false;

  /// @brief The distance in meters from the launch altitude
  int32_t distance_from_ground_m = 0;
  bool distance_from_ground_valid = false;

  /// @brief The average horizontal speed in meters per second over the last
  /// minute.
  bool average_speed_valid = false;
  int32_t average_horiz_speed_mps_1min = 0;

  /// @brief The average vertical speed in meters per second over the last
  /// minute.
  int32_t average_vert_speed_mps_1min = 0;

  int32_t max_horizontal_speed_mps = 0;
  int32_t max_vertical_speed_mps = 0;
  bool max_speed_valid = false;

  /// @brief The current RSSI value for the data link.
  /// @details Most up to date value.
  double uplink_rssi = 0.0;
  bool uplink_rssi_valid = false;

  /// @brief \c true if we currently have a 3D GPS fix.
  bool gps_fix_valid = false;

  Json toJson() {
    Json json_data;
    json_data["battery_voltage_mv"] = battery_voltage_mv;
    json_data["battery_voltage_mv_valid"] = battery_voltage_mv_valid;
    json_data["battery_current_ma"] = battery_current_ma;
    json_data["battery_current_ma_valid"] = battery_current_ma_valid;
    json_data["battery_usage_mah"] = battery_usage_mah;
    json_data["battery_usage_mah_valid"] = battery_usage_mah_valid;
    json_data["battery_state_of_charge"] = battery_state_of_charge;
    json_data["battery_state_of_charge_valid"] = battery_state_of_charge_valid;
    json_data["external_temperature_c"] = external_temperature_c;
    json_data["external_temperature_valid"] = external_temperature_valid;
    json_data["relative_humidity"] = relative_humidity;
    json_data["relative_humidity_valid"] = relative_humidity_valid;
    json_data["barometric_pressure_mbar"] = barometric_pressure_mbar;
    json_data["barometric_pressure_valid"] = barometric_pressure_valid;
    json_data["pressure_altitude_m"] = pressure_altitude_m;
    json_data["pressure_altitude_valid"] = pressure_altitude_valid;
    json_data["pressure_vertical_speed"] = pressure_vertical_speed;
    json_data["pressure_vertical_speed_valid"] = pressure_vertical_speed_valid;
    json_data["distance_traveled_m"] = distance_traveled_m;
    json_data["distance_traveled_valid"] = distance_traveled_valid;
    json_data["distance_from_launch_m"] = distance_from_launch_m;
    json_data["distance_from_launch_valid"] = distance_from_launch_valid;
    json_data["distance_from_ground_m"] = distance_from_ground_m;
    json_data["distance_from_ground_valid"] = distance_from_ground_valid;
    json_data["average_speed_horiz_mps_1min"] = average_horiz_speed_mps_1min;
    json_data["average_speed_vert_mps_1min"] = average_vert_speed_mps_1min;
    json_data["average_speed_valid"] = average_speed_valid;
    json_data["max_horiz_speed_mps"] = max_horizontal_speed_mps;
    json_data["max_vert_speed_mps"] = max_vertical_speed_mps;
    json_data["max_speed_valid"] = max_speed_valid;
    json_data["uplink_rssi"] = uplink_rssi;
    json_data["uplink_rssi_valid"] = uplink_rssi_valid;
    json_data["gps_fix_valid"] = gps_fix_valid;
    return json_data;
  }
};

} // namespace blocks

} // namespace data

#endif
