joshua-jerred/Giraffe/src/flight_system/interface/ubx.h

/**
 * @file ubx.h
 * @author Joshua Jerred (https://joshuajer.red/)
 * @brief Public interface for the u-blox protocol
 * 
 * @version 0.3
 * @date 2023-01-06
 * @copyright Copyright (c) 2023
 * 
 * @todo remove the macros, they're not needed
 */

#ifndef UBX_H_
#define UBX_H_

#include <cstdint>
#include <vector>
#include "interface.h"


/** @todo These macros should be changed to something else */
// UBX Class IDs ---------------------------------------------------------------
// Comments are directly from the u-blox spec
#define UBX_CLASS_NAV 0x01 // Navigation Results Messages: Position, Speed, Time, Acceleration, Heading, DOP, SVs used
#define UBX_CLASS_INF 0x04 // Information Messages: Printf-Style Messages, with IDs such as Error, Warning, Notice
#define UBX_CLASS_ACK 0x05 // Ack/Nak Messages: Acknowledge or Reject messages to UBX-CFG input messages
#define UBX_CLASS_CFG 0x06 // Configuration Input Messages: Configure the receiver.
#define UBX_CLASS_MON 0x0A // Monitoring Messages: Communication Status, CPU Load, Stack Usage, Task Status
#define UBX_CLASS_MGA 0x13 // Multiple GNSS Assistance Messages: Assistance data for various GNSS

// UBX Message IDs -------------------------------------------------------------
// Class comments above each section. Same order as data sheet
// ACK
#define UBX_ACK_ACK 0x01
#define UBX_ACK_NAK 0x00
// CFG
#define UBX_CFG_CFG 0x09 // Clear, Save, and Load Configurations
#define UBX_CFG_DAT 0x06 // Set User-defined Datum or get the currently defined Datum
#define UBX_CFG_GEOFENCE 0x69 // Geofencing configuration
#define UBX_CFG_GNSS 0x3E // GNSS system configuration
#define UBX_CFG_INF 0x02 // Poll configuration for one protocol
#define UBX_CFG_ITFM 0x39 // Jamming/Interference Monitor configuration
#define UBX_CFG_LOGFILTER 0x47 // Data Logger Configuration
#define UBX_CFG_MSG 0x01 // Poll a message configuration, set message rate(s)
#define UBX_CFG_NMEA 0x17 // NMEA protocol configuration
#define UBX_CFG_ODO 0x1E // Odometer, Low-speed COG Engine Settings
#define UBX_CFG_PMS 0x86 // Power Management Settings
#define UBX_CFG_PRT 0x00 // Port Configuration for UART, USB, SPI
#define UBX_CFG_PWR 0x57 // Put receiver in a defined power state
#define UBX_CFG_RATE 0x08 // Navigation/Measurement Rate Settings
#define UBX_CFG_RST 0x04 // Reset Receiver / Clear Backup Data
// INF
#define UBX_INF_DEBUG 0x04 // ASCII output with debug contents
#define UBX_INF_ERROR 0x00 // ASCII output with error contents
#define UBX_INF_NOTICE 0x02 // ASCII output with informational contents
#define UBX_INF_TEST 0x03 // ASCII output with test contents
#define UBX_INF_WARNING 0x01 // ASCII output with warning contents
// MON
#define UBX_MON_HW 0x09 // Hardware Status
#define UBX_MON_IO 0x02 // I/O system status
#define UBX_MON_MSGPP 0x06 // Message Parse and Process Status
#define UBX_MON_RXR 0x21 // Receiver Status Information
#define UBX_MON_VER 0x04 // Receiver/Software Version
// NAV
#define UBX_NAV_AOPSTATUS 0x60 // AssistNow Autonomous Status
#define UBX_NAV_CLOCK 0x22 // Clock Solution
#define UBX_NAV_DOP 0x04 // Dilution of precision
#define UBX_NAV_EELL 0x3D // Position error ellipse parameters
#define UBX_NAV_EOE 0x61 // End of Epoch
#define UBX_NAV_GEOFENCE 0x39 // Geofencing status
#define UBX_NAV_ODO 0x09 // Odometer Solution
#define UBX_NAV_ORB 0x34 // GNSS Orbit Database Info
#define UBX_NAV_POSECEF 0x01 // Position Solution in ECEF
#define UBX_NAV_POSLLH 0x02 // Geodetic Position Solution
#define UBX_NAV_PVT 0x07 // Navigation Position Velocity Time Solution
#define UBX_NAV_RELPOSNED 0x3C // Relative Positioning Solution
#define UBX_NAV_RESETODO 0x10 // Reset odometer
#define UBX_NAV_SAT 0x35 // Satellite Information
#define UBX_NAV_SBAS 0x32 // SBAS Status
#define UBX_NAV_SOL 0x06 // Navigation Solution Information
#define UBX_NAV_STATUS 0x03 // Receiver Navigation Status
#define UBX_NAV_SVINFO 0x30 // Space Vehicle Information
#define UBX_NAV_TIMELS 0x26 // Leap Second Event Information
#define UBX_NAV_TIMEUTC 0x21 // UTC Time Solution
#define UBX_NAV_VELECEF 0x11 // Velocity Solution in ECEF
#define UBX_NAV_VELNED 0x12 // Velocity Solution in NED

namespace ubx
{
    enum class ACK {
        ACK,
        NACK,
        NONE,
        WRITE_ERROR,
        READ_ERROR
    };

    enum class DYNAMIC_MODEL {
        PORTABLE = 0x00,
        STATIONARY = 0x02,
        PEDESTRIAN = 0x03,
        AUTOMOTIVE = 0x04,
        SEA = 0x05,
        AIRBORNE_1G = 0x06,
        AIRBORNE_2G = 0x07,
        AIRBORNE_4G = 0x08,
        ERROR = 0xFF
    };

    enum class FIX_TYPE {
        NO_FIX = 0x00,
        DEAD_RECK = 0x01,
        FIX_2D = 0x02,
        FIX_3D = 0x03,
        COMBINED = 0x04,
        TIME_ONLY = 0x05,
        ERROR = 0xFF
    };

    struct NAV_DATA {
        bool valid = false;
        int year = 0;
        int month = 0;
        int day = 0;
        int hour = 0;
        int minute = 0;
        int second = 0;
        
        FIX_TYPE fixType = FIX_TYPE::NO_FIX;

        int num_satellites = 0;
        double longitude = 0.0;  // degrees
        double latitude = 0.0;   // degrees
        double horz_accuracy = 0.0; // meters

        double altitude = 0.0;  // meters
        double vert_accuracy = 0.0; // meters

        double ground_speed = 0.0; // meters/second
        double speed_accuracy = 0.0; // meters/second

        double heading_of_motion = 0.0; // degrees
        double heading_accuracy = 0.0;  // degrees
    };

    typedef struct UBXMessage 
    {
        UBXMessage() {};
        UBXMessage(std::uint8_t class_ID, 
            std::uint8_t msg_ID, 
            std::uint16_t length, 
            std::uint8_t *payload);
        bool calculateChecksum();
        bool verifyChecksum();
        std::uint8_t sync1 = 0;
        std::uint8_t sync2 = 0;
        std::uint8_t mClass = 0;
        std::uint8_t mID = 0;
        std::uint16_t length = 0;
        std::uint8_t *payload = nullptr;
        std::uint8_t ck_a = 0;
        std::uint8_t ck_b = 0;
    } UBXMessage;

    int getStreamSize(interface::I2C &i2c);
    bool flushStream(interface::I2C &i2c);
    bool writeUBX(interface::I2C &i2c, const UBXMessage &message);
    bool readNextUBX(interface::I2C &i2c, UBXMessage &message);
    bool readSpecificMessage(
        interface::I2C &i2c, 
        ubx::UBXMessage &message); // message should have class, id, and length set
    ACK checkForAck(
        interface::I2C &i2c, 
        const uint8_t msg_class, 
        const uint8_t msg_id);

    bool sendResetCommand(interface::I2C &i2c);

    ACK setProtocolDDC(interface::I2C &i2c, const bool extended_timeout);
    ACK setMessageRate(
        interface::I2C &i2c, 
        uint8_t msg_class, 
        uint8_t msg_id, 
        uint8_t rate);
    ACK setMeasurementRate(interface::I2C &i2c, const uint16_t rate_ms);
    ACK setDynamicModel(
        interface::I2C &i2c,
        const DYNAMIC_MODEL model
    );

    bool pollMessage(
        interface::I2C &i2c,
        ubx::UBXMessage &message,
        const uint8_t msg_class,
        const uint8_t msg_id,
        const int expected_size,
        const unsigned int timeout_ms = 1500);

    // UBXMessage getConfiguration
    bool parsePVT(const UBXMessage &message, NAV_DATA &data);

    // ---------- DEBUGGING ----------
    std::ostream& operator<<(std::ostream& o, const UBXMessage& ubx);
    std::ostream& operator<<(std::ostream& o, const NAV_DATA& nv);
    
    const std::unordered_map<uint8_t, std::string> UbxClassToString = {
        {UBX_CLASS_NAV, "NAV"},
        {UBX_CLASS_INF, "INF"},
        {UBX_CLASS_ACK, "ACK"},
        {UBX_CLASS_CFG, "CFG"},
        {UBX_CLASS_MON, "MON"},
        {UBX_CLASS_MGA, "MGA"}
    };
    const std::unordered_map<uint8_t, std::string> UbxIdToString = {
        {UBX_ACK_ACK, "ACK"},
        {UBX_ACK_NAK, "NAK"},
        {UBX_CFG_CFG, "CFG"},
        {UBX_CFG_DAT, "DAT"},
        {UBX_CFG_GEOFENCE, "GEOFENCE"},
        {UBX_CFG_GNSS, "GNSS"},
        {UBX_CFG_INF, "INF"},
        {UBX_CFG_ITFM, "ITFM"},
        {UBX_CFG_LOGFILTER, "LOGFILTER"},
        {UBX_CFG_MSG, "MSG"},
        {UBX_CFG_NMEA, "NMEA"},
        {UBX_CFG_ODO, "ODO"},
        {UBX_CFG_PMS, "PMS"},
        {UBX_CFG_PRT, "PRT"},
        {UBX_CFG_PWR, "PWR"},
        {UBX_CFG_RATE, "RATE"},
        {UBX_CFG_RST, "RST"},
        {UBX_INF_DEBUG, "DEBUG"},
        {UBX_INF_ERROR, "ERROR"},
        {UBX_INF_NOTICE, "NOTICE"},
        {UBX_MON_MSGPP, "MSGPP"},
        {UBX_MON_RXR, "RXR"},
        {UBX_MON_VER, "VER"},
        {UBX_NAV_AOPSTATUS, "AOPSTATUS"},
        {UBX_NAV_CLOCK, "CLOCK"},
        {UBX_NAV_DOP, "DOP"},
        {UBX_NAV_EELL, "EELL"},
        {UBX_NAV_EOE, "EOE"},
        {UBX_NAV_GEOFENCE, "GEOFENCE"},
        {UBX_NAV_ODO, "ODO"},
        {UBX_NAV_ORB, "ORB"},
        {UBX_NAV_POSECEF, "POSECEF"},
        {UBX_NAV_POSLLH, "POSLLH"},
        {UBX_NAV_PVT, "PVT"},
        {UBX_NAV_RELPOSNED, "RELPOSNED"},
        {UBX_NAV_RESETODO, "RESETODO"},
        {UBX_NAV_SAT, "SAT"},
        {UBX_NAV_SBAS, "SBAS"},
        {UBX_NAV_SOL, "SOL"},
        {UBX_NAV_STATUS, "STATUS"},
        {UBX_NAV_SVINFO, "SVINFO"},
        {UBX_NAV_TIMELS, "TIMELS"},
        {UBX_NAV_TIMEUTC, "TIMEUTC"},
        {UBX_NAV_VELECEF, "VELECEF"},
        {UBX_NAV_VELNED, "VELNED"}
    };
    // -------------------------------
} // namespace ubx

#endif // UBX_H_
