joshua-jerred/Giraffe/src/flight_system/shared_data/shared_data.hpp

/**
 * =*========GIRAFFE========*=
 * A Unified Flight Command and Control System
 * https://github.com/joshua-jerred/Giraffe
 * https://giraffe.joshuajer.red/
 * =*=======================*=
 *
 * @file   shared_data.hpp
 * @brief  Contains the SharedData struct, used across all modules and
 * extensions.
 *
 * =*=======================*=
 * @author     Joshua Jerred (https://joshuajer.red)
 * @date       2023-06-07
 * @copyright  2023 (license to be defined)
 */

#ifndef SHARED_DATA_HPP_
#define SHARED_DATA_HPP_

#include <BoosterSeat/clock.hpp>
#include <BoosterSeat/time.hpp>

#include "blocks.hpp"
#include "error_frame.hpp"
#include "flight_data.hpp"
#include "flight_phase.hpp"
#include "frame.hpp"
#include "log_container.hpp"
#include "status_led.hpp"
#include "streams.hpp"

class FlightRunner;

namespace data {
struct Streams {
  DataStream data{};
  LogStream log{};
  GpsFrameStream gps{};
  ImuFrameStream imu{};

  /**
   * @brief The command stream. Parsed by the flight runner, not the data
   * module.
   */
  CommandStream command{};
};

struct SharedBlocks {
  blocks::Block<blocks::StreamsStats> stream_stats{};
  blocks::Block<blocks::ModulesStatuses> modules_statuses{};
  blocks::Block<blocks::ServerModuleStats> server_module_stats{};
  blocks::Block<blocks::DataLogStats> data_log_stats{};
  blocks::Block<blocks::SystemInfo> system_info{};
  blocks::Block<blocks::ExtensionModuleStats> extension_module_stats{};
  blocks::Block<blocks::LocationData> location_data{};
  blocks::Block<blocks::ImuData> imu_data{};
  blocks::Block<blocks::CameraImages> camera{};
  blocks::Block<blocks::TelemetryModuleStats> telemetry_module_stats{};
  blocks::Block<blocks::CalculatedData> calculated_data{};
  blocks::Block<blocks::FileSystemData> file_system_data{};
};

/// @brief ADC Value containing <raw_count, interpolated_value>
using AdcValue = std::pair<uint32_t, double>;
struct Frames {
  /**
   * @brief Data frame containing all active error messages.
   */
  ErrorFrame error_frame{};

  /**
   * @brief Temperature data from environmental extensions.
   */
  Frame<std::string, DataPacket> env_temp{};

  /**
   * @brief Pressure data from environmental extensions.
   */
  Frame<std::string, DataPacket> env_pres{};

  /**
   * @brief Humidity data from environmental extensions.
   */
  Frame<std::string, DataPacket> env_hum{};

  /**
   * @brief ADC data frame. std::string is the label of the ADC channel, and
   * the double is the interpolated value.
   */
  Frame<std::string, AdcValue> adc{};
};

/**
 * @brief Data that is shared across all modules and extensions.
 */
struct SharedData {
  data::FlightData flight_data = FlightData();
  Streams streams = Streams();
  Frames frames = Frames();
  SharedBlocks blocks{};
  LogContainer log_container{};
  giraffe::StatusLedState status_led{};
};

Json toJson(data::Frame<std::string, data::DataPacket> &frame);
Json toJson(data::Frame<std::string, data::AdcValue> &frame);

} // namespace data

#endif
