joshua-jerred/Giraffe/src/flight_system/modules/data/positional.hpp

/**
 * =*========GIRAFFE========*=
 * A Unified Flight Command and Control System
 * https://github.com/joshua-jerred/Giraffe
 * https://giraffe.joshuajer.red/
 * =*=======================*=
 *
 * @file   positional.hpp
 * @brief  Positional data for the flight system (gps/imu data)
 *
 * =*=======================*=
 * @author     Joshua Jerred (https://joshuajer.red)
 * @date       2023-06-14
 * @copyright  2023 (license to be defined)
 */

#ifndef POSITIONAL_HPP_
#define POSITIONAL_HPP_

#include <cstdint>
#include <map>
#include <string>

#include <nlohmann/json.hpp>
using json = nlohmann::json;

#include <BoosterSeat/clock.hpp>
#include <BoosterSeat/time.hpp>

namespace data {

enum class GpsFix : uint8_t { ERROR = 0, NO_FIX = 1, FIX_2D = 2, FIX_3D = 3 };

static const std::map<GpsFix, std::string> K_GPS_FIX_TO_STRING_MAP = {
    {GpsFix::ERROR, "error_fix"},
    {GpsFix::NO_FIX, "no_fix"},
    {GpsFix::FIX_2D, "2d_fix"},
    {GpsFix::FIX_3D, "3d_fix"}};

/**
 * @brief A frame of GPS data straight from a GPS extension.
 */
struct GpsFrame {
  /// @brief The UTC time of the GPS fix from the actual GPS clock.
  bst::clck::TimePoint gps_utc_time = bst::clck::TimePoint();

  /// @brief This is generated by the extension, the data may still not be
  /// reliable.
  bool is_valid = false;

  /// @brief The GPS fix type.
  GpsFix fix = GpsFix::ERROR;

  /// @brief The number of satellites used to calculate the fix.
  uint8_t num_satellites = 0;

  /// @brief The latitude in decimal degrees.
  double latitude = 0.0;

  /// @brief The longitude in decimal degrees.
  double longitude = 0.0;

  /// @brief The horizontal accuracy in meters.
  double horz_accuracy = 0.0;

  /// @brief The altitude in meters.
  double altitude = 0.0;

  /// @brief The vertical accuracy in meters.
  double vert_accuracy = 0.0;

  /// @brief The vertical speed in meters/second.
  double vertical_speed = 0.0;

  /// @brief The horizontal speed in meters/second.
  double horizontal_speed = 0.0;

  /// @brief The horizontal speed accuracy in meters/second.
  double speed_accuracy = 0.0;

  /// @brief The heading of motion in degrees. (not magnetic)
  double heading_of_motion = 0.0;

  /// @brief The heading of motion accuracy in degrees.
  double heading_accuracy = 0.0;

  int getAgeSeconds() const {
    return bst::clck::secondsElapsed(gps_utc_time);
  }
};

void to_json(json &j, const data::GpsFrame &frame);

/**
 * @brief A frame of +IMU data, straight from an IMU extension.
 */
struct ImuFrame {
  /**
   * @brief The time of the IMU frame, generated by the system.
   */
  bst::clck::TimePoint time = bst::clck::now();

  /**
   * @brief The extension will set this to true if it thinks the data is valid.
   */
  bool is_valid = false;

  /**
   * @brief X, Y, and Z acceleration in meters/second^2.
   * @defgroup acceleration Acceleration
   * @{
   */
  double x_acceleration = 0.0;
  double y_acceleration = 0.0;
  double z_acceleration = 0.0;
  /** @} */

  /**
   * @brief X, Y, and Z rotation in degrees/second.
   * @defgroup rotation Rotation
   * @{
   */
  double x_angular_velocity = 0.0;
  double y_angular_velocity = 0.0;
  double z_angular_velocity = 0.0;
  /** @} */
};

/**
 * @brief Checks if a GPS frame contains valid location data.
 * @details Simply checks if the data fields are within logical bounds. Does
 * not have any knowledge of the previous location, so it cannot check
 * for a sudden jump in position. This also checks for a time skew of
 * less than 1 day in the hopes that the system data is correct.
 *
 * @param frame - The frame to check.
 * @return true - If the frame is valid.
 * @return false - If the frame is invalid.
 */
bool isGpsFrameValid(const data::GpsFrame &frame);

/**
 * @brief Checks if an IMU frame contains valid data.
 * @details Checks if the data fields are within logical bounds.
 * Currently these bounds are based off of the BMI088 IMU.
 * @param frame - The frame to check.
 * @return true - If the frame is valid.
 * @return false - If the frame is invalid.
 */
bool isImuFrameValid(const data::ImuFrame &frame);

} // namespace data

#endif /* POSITIONAL_HPP_ */
