joshua-jerred/Giraffe/(commit log)

2022-10-02 First running build (#1)
    * README Edit
    * Implemented the main function for the flight computer in main.cpp
    * Initial Doxygen configuration.
    * Instructures for Doxygen documentation.
    * Wrote basic README
    * Fixed README format
    * Update to readme
    * Initial README
    * License Added
    * First Commit of the extension class, needs documentation.
    * Initial Commit of test-ext
    * Initial Commit for Modules
    * Final Initial Commit, contains utilities and fhte flight runner.
    * Updates to cmake file for test-01
    [extension.cpp, main.cpp, module-extensions.cpp]
2022-10-02 Basic extension threading. Working example.
2022-10-09 Cleaned up notes, adding comments.
    [gfc.kicad_pcb, gfc.kicad_sch]
2022-10-16 Added error logging functionality
    [module-console.cpp]
2022-10-25 Sync changes - extension shutdown fixed
    [extension.cpp, main.cpp, module-extensions.cpp, simulated-extensions.cpp]
2022-10-26 Fixed server shutdown (Non-Blocking) and Console
    [module-console.cpp]
2022-10-31 Added error frame
2022-11-01 Basic I2C utility
2022-11-01 i2c and bmp180 added
2022-11-02 Fixed minor compilation bugs
    [bmp180.cpp, extension.cpp]
2022-11-29 Fixed bug where once a TX starts the server module fails
    [simulated-extensions.cpp]
2022-11-29 Fixed all deconstructors that deal with thread stopping
2022-11-29 SAM-M8Q Prototype Board
    [SAM-M8Q Proto Board.kicad_pcb, SAM-M8Q Proto Board.kicad_sch]
2022-11-29 Started GFC
    [GFC.kicad_pcb, GFC.kicad_sch]
2022-11-30 Continued work on schematic for GFC. Added BMP390 and DRA818
    [BMP390.kicad_sch, DRA818.kicad_sch, GFC.kicad_sch, Power.kicad_sch, untitled.kicad_sch]
2022-11-30 Sync board
    [BMP390.kicad_sch, GFC.kicad_sch, SAM-M8Q.kicad_sch]
2022-12-05 Some hardware changes, started to add footprints and part links to digikey. Switching most to SMD
    [BMP390.kicad_sch, DRA818.kicad_sch, GFC.csv, GFC.kicad_sch, Power.kicad_sch, SAM-M8Q.kicad_sch]
2022-12-05 Updated footprints - Started work on PCB layout
    [BMP390.kicad_sch, DRA818.kicad_sch, GFC.kicad_pcb, GFC.kicad_sch, Power.kicad_sch, SAM-M8Q.kicad_sch]
2022-12-06 Sync PCB
    [DRA818.kicad_sch, GFC.kicad_pcb, GFC.kicad_sch, Power.kicad_sch]
2022-12-07 Schematic Update - ADC/DAC & GPIO Config EEPROM
    [1-Wire_Connection.kicad_sch, BMP390.kicad_sch, DRA818.kicad_sch, EEPROM.kicad_sch, GFC.kicad_pcb, GFC.kicad_sch, Power.kicad_sch, SAM-M8Q.kicad_sch]
2022-12-10 Cleaning up the hardware directory
    [1-Wire_Connection.kicad_sch, BMP390.kicad_sch, DRA818.kicad_sch, EEPROM.kicad_sch, GFC-prototypes.kicad_pcb, GFC-prototypes.kicad_sch, GFC.csv, GFC.kicad_pcb]
2022-12-11 PCB Prototype
    [1-Wire_Connection.kicad_sch, BME280.kicad_sch, BMP390.kicad_sch, GFC-prototypes.kicad_pcb, GFC.kicad_pcb, GFC.kicad_sch, GFC_HAT.kicad_sch, GFC_SHOE.kicad_sch]
2022-12-16 Hardware Update
    [GFC.kicad_pcb, GFC.kicad_sch, GFC_HAT.kicad_sch]
2022-12-18 Hardware refresh, removed layered sheets and split hat and shoe
    [1-Wire_Connection.kicad_sch, BME280 Proto Board.kicad_pcb, BME280 Proto Board.kicad_sch, BME280.kicad_sch, BMP390.kicad_sch, DRA818.kicad_sch, EEPROM.kicad_sch, GFC Shoe.kicad_pcb]
2022-12-19 Started making some revisions to Prototype 2, cleaned up files.
    [DRA818.kicad_sch, GFC-Hat.kicad_pcb, GFC-Hat.kicad_sch, GFC_SHOE.kicad_sch, SAM-M8Q.kicad_sch, dac.kicad_sch]
2022-12-19 Spent a few hours fixing an incredible wall of warnings. Way too many data members were being used uninitialized.
    [bmp180.cpp, ds18b20.cpp, extension.cpp, module-console.cpp, module-extensions.cpp, simulated-extensions.cpp]
2022-12-20 I2C Updates and Test
2022-12-20 i2c test update
2022-12-20 Force I2C to take over device from kernel
2022-12-20 I2C test update, initialization, and force driver.
2022-12-20 Work on BMP180 Extension and test-06. Added cout<<ErrorStreamPacket override
    [bmp180.cpp, extension.cpp, module-console.cpp]
2022-12-20 Handshake register isn't a short, changed to int. Error Packet will not include binary of the inaccurate response.
    [bmp180.cpp]
2022-12-20 cout<<DataStreamPacket override and updated BMP180 test to print out data
2022-12-20 Error checking of usleep system call
    [bmp180.cpp]
2022-12-20 Fixed critical bug with I2C class, argument order was incorrect on writeByteToReg
    [bmp180.cpp]
2022-12-24 Added error to ds18b20
    [ds18b20.cpp]
2022-12-27 GitHub actions update for new units tests - need to switch systems
2022-12-27 Added I2C writeChunk and readChunk, initial implementation of UBX utility, added unit test-08 for UBX testing.
2022-12-28 PCB update
    [DRA-818 Proto Board.kicad_pcb, DRA-818 Proto Board.kicad_sch, PCM2902C Proto Board.kicad_pcb, PCM2902C Proto Board.kicad_sch]
2022-12-29 DRA818 Schematic Update
    [DRA-818 Proto Board.kicad_sch, GFC Shoe.kicad_sch, GFC_SHOE.kicad_sch]
2022-12-30 BME280 Initial Driver (Untested)
2022-12-31 BME280 Driver Complete
2022-12-31 Updated configuration file to reflect installed sensors
2023-01-02 MAX17049 driver initial test
2023-01-03 Thread safe I2C transactions (read chunk)
2023-01-03 Fixed tests for thread safe I2C transactions
    [max17049.cpp]
2023-01-04 Started work on MAX17049 driver, hardware is wrong.
    [max17049.cpp]
2023-01-04 Telemetry only includes data types listed in config now instead of the full data frame.
2023-01-05 GFC Prototype 2 Complete and ordered - with BOM
    [GFC-Hat.kicad_pcb, GFC-Hat.kicad_sch]
2023-01-05 More work fighting with the SAM-M8Q via I2C and it's DDC interface. Eventually this should just be switched over to a MCU that takes care of the processing that you can then read from via simple I2C 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
2023-01-06 Schematic update
    [GFC-Hat.kicad_sch]
2023-01-07 Catching extensions in error states
    [extension.cpp, extensions.h, module-extensions.cpp, sysinfo.cpp]
2023-01-07 Updated data module test, i2c test, and fixed warning for float comparison in BMP180 driver
    [bmp180.cpp]
2023-01-07 Doc changes and SAM-M8Q fix
    [samm8q.cpp]
2023-01-07 Removed GPS schematic
    [SAM-M8Q.kicad_sch]
2023-01-07 sync changes
    [DRA-818 Proto Board.kicad_sch]
2023-01-08 GFC RF Proto Board Schematic update
    [DRA-818 Proto Board.kicad_sch]
2023-01-09 Radio module protoboard
    [DRA-818 Proto Board.kicad_pcb, DRA-818 Proto Board.kicad_sch]
2023-01-12 Radio/Sound Card PCB Update
    [GFC Shoe.kicad_pcb, GFC Shoe.kicad_sch, SA868.kicad_sch, Sound Card.kicad_sch]
2023-01-13 PCB Reference Updates
    [GFC Shoe.kicad_sch, SA868.kicad_sch, Sound Card.kicad_sch]
2023-01-15 Large rework of data module and preparation for web server integration
    [config-types.h, data-stream.cpp, data-stream.h, extension.cpp, extensions.h, gfs-types.h, module-console.cpp, module-extensions.cpp]
2023-01-15 DataStream no longer a pointer, passed by reference.
    [data-stream.cpp, data-stream.h, module-console.cpp, module-extensions.cpp, status.h]
2023-01-29 Minor hardware updates
    [GFC Shoe.kicad_pcb, GFC Shoe.kicad_sch, SA868.kicad_sch, Sound Card.kicad_sch]
2023-01-29 re-work of sim sensors
2023-02-04 SA868 hardware testing code (Arduino)
2023-02-07 test-12 i2c bus fix
2023-02-13 - Battery Voltage Rounding on web-server - Added vertical speed to GPSFrame
2023-02-15 Implemented data module command infrastructure
    Implemented 'clear all errors' command in the data module
    [gfs-types.h]
2023-02-25 Data/Error log path update
    [ubx.cpp]
2023-02-26 Log/Error files on web server
    [data-stream.h]
2023-02-26 Log file list shows current file.
    Added 'clear errors' button to web server along with 'rotate log file'
2023-02-26 Outline for Radio and Camera Driver
2023-03-06 Number of current errors
    [data-stream.cpp, data-stream.h, gfs-types.h]
2023-03-17 raspberry pi camera temporary implementation
2023-04-29 http switch
2023-04-30 socket implementation
2023-04-30 socket data_stream_request
2023-05-05 Web Socket API Progress
2023-05-10 gfs unit test structure update
    [configuration.h, configuration_structures.h]
2023-05-10 validators start
    [configuration.h, configuration_defaults.h, configuration_structures.h]
2023-05-13 config restructure
    [configuration_defaults.h, configuration_internal.h, configuration_structures.h]
2023-05-13 unit test updates
    [configuration.h, configuration_internal.h, configuration_structures.h]
2023-05-15 validator updates through telemetry
    [configuration.h, configuration_internal.h]
2023-05-15 gfs test_02 functional
    [configuration.h, configuration_internal.h]
2023-05-15 configuration toJson with unit test
    [configuration.h, configuration_internal.h]
2023-05-15 gfs tojson functions complete for now
    [configuration_internal.h]
2023-05-15 basic config save
    [configuration_internal.h]
2023-05-16 gfs exception
    [configuration.h, configuration_exception.h, configuration_internal.h]
2023-05-16 cfg load file test
    [configuration_internal.h]
2023-05-16 stream test
    [configuration.h, configuration_internal.h]
2023-05-16 save test complete
    [configuration.h, configuration_internal.h]
2023-05-16 started on helpers for config loading
    [configuration.h, configuration_exception.h, configuration_internal.h]
2023-05-16 config loading complete for now
    [configuration.h, configuration_internal.h]
2023-05-20 flightrunner overhaul
    [configuration.h, configuration_module.h]
2023-05-21 configuration module removal
    [configuration.h, configuration_internal.h, configuration_module.h]
2023-05-21 Fix of the "Static Initialization Order Fiasco" with the configuration module and it's maps.
    [configuration.h, configuration_internal.h]
2023-05-21 Server Module framework
2023-05-21 socket revamp start
2023-05-21 base socket implementation and system info stream
2023-05-22 Sync Large Configuration Changes
    [configuration.h, configuration_internal.h]
2023-05-22 console module configuration fix
    [configuration.h]
2023-05-23 streams, frames, and blocks
    [configuration.h, configuration_internal.h]
2023-05-25 removed old config
    [configuration.h, configuration_internal.h]
2023-05-27 Generators switched to tasks, no longer part of cmake configure
    [streams.hpp]
2023-05-27 rework with config generator
    [blocks.hpp, console_module.cpp, curses_utilities.cpp, data_module.cpp, data_module.h]
2023-05-30 config get via tcp socket
2023-06-02 data_log base prototypes
2023-06-05 Hardware update to bring it up to KiCad 7.0
    [GFC-Hat.kicad_pcb, GFC-Hat.kicad_sch]
2023-06-07 booster seat update with file system functions
    [GFC-Hat.kicad_pcb]
2023-06-10 ground station refactor
2023-06-12 GFS data connection in the GGS web socket
2023-06-14 imu/gps streams
2023-06-23 hardware and latex updates
    [5v Power Supply.kicad_pcb, 5v Power Supply.kicad_sch, DRA-818 Proto Board.kicad_sch]
2023-06-30 imu frame processing
2023-07-01 error frame base implementation
    [error_frame.cpp, error_frame.hpp, frame.hpp, shared_data.hpp]
2023-07-01 error frame in the console module
    [console_pages.cpp, console_pages.hpp, data_module.cpp, data_module.h, log_container.hpp, shared_data.hpp, to_string.cpp, to_string.hpp]
2023-07-01 error logging to file implemented for both planned strategies
    [data_formatting.cpp, data_formatting.hpp, data_log.cpp, data_log.hpp, data_module.cpp]
2023-07-01 camera image path
2023-07-01 camera image file paths
2023-07-02 i2c bus configuration item
2023-07-03 I2C interface updates with host based unit test
2023-07-05 unit test fixes for GPS frame change
    [to_string.cpp]
2023-07-06 ADC configuration strings
2023-07-06 adc config docs, I2C extension adapter, and new error IDs
    [adc_extension_base.hpp, i2c_extension_adapter.hpp]
2023-07-06 MCP3021 in voltage divider configuration working as expected
2023-07-06 Added voltage reference
2023-07-11 hardware updates
    [GFC-Hat.kicad_sch, giraffe_flight_computer.kicad_pcb, giraffe_flight_computer.kicad_sch, power_supply.kicad_sch]
2023-07-11 data module 'clear all errors' command
    [data_module.cpp]
2023-07-11 clear individual error command
    [data_module.cpp]
2023-07-12 new PCB and Schematic
    [BMI088.step, CAT24C32WI_GT3.step, DRA818.kicad_sch, GFC Shoe.kicad_pcb, GFC Shoe.kicad_sch, GFC-Hat.kicad_pcb, GFC-Hat.kicad_sch, GFC.kicad_sch]
2023-07-13 schematic rev A initial design
    [BMI088.step, CAT24C32WI_GT3.step, MolexSmaConnector.step, giraffe_flight_computer.kicad_pcb, giraffe_flight_computer.kicad_sch]
2023-07-14 More schematic changes
    [giraffe_flight_computer.kicad_sch, hat.kicad_sch, shoe.kicad_sch]
2023-07-16 Rev A Hat Complete
    [Murata_-_LQH3NPH680MMEL.step, giraffe_flight_computer.kicad_pcb, giraffe_flight_computer.kicad_sch, hat.kicad_sch, shoe.kicad_sch]
2023-07-18 More hardware updates
    [giraffe_flight_computer.kicad_pcb]
2023-07-22 Giraffe Flight Computer Hat REV A complete
    [giraffe_flight_computer.kicad_pcb, giraffe_flight_computer.kicad_sch]
2023-10-14 Doxygen for ubx, cfg_extensions, i2c_extension_adapter
2023-10-14 doxygen build errors fix
    [cfg_section.hpp, frame.hpp, i2c_interface.hpp, shared_data.hpp, ubx_protocol.cpp, ubx_protocol.hpp]
2023-12-11 Calculated data - pressure altitude
2023-12-16 BoosterSeat timer update
2024-01-13 Added debugging page to the ground station
2024-01-13 gdl socket updates
2024-01-13 gdl terminal status via tcp socket
2024-01-14 minor logic fix for location data in the ground station software
2024-01-23 new socket connection method in ggs
2024-01-24 CI - Ground Station CMake configure
2024-01-24 CI Ground Station - Take Ownership
2024-01-24 Ground Station CI - recurse sub modules
2024-01-24 ground station recurse in CI
2024-01-24 calculated data rolling average fix
    [data_module.cpp, data_module.hpp, simulated_extensions.hpp]
2024-01-24 status led, extension module extensions, gpio
2024-01-26 spi test
2024-01-27 bmi088 spi test
2024-01-27 SPI interface test
2024-01-27 imu gyro functional
2024-02-13 status led data sharing
    [giraffe_flight_computer.kicad_sch, hat.kicad_sch, shoe.kicad_sch]
2024-02-13 status LED Extension
2024-02-13 pi camera progress
2024-02-13 pi camera
2024-02-14 sim adc
2024-02-15 report an error on samm8q time parse failure, removed shutdown on assert in debug mode
    [main.cpp, samm8q.cpp, ubx_protocol.hpp]
2024-02-15 Removal of EXT_DEBUG, fixed logging levels.
    [data_log.cpp, ds18b20.cpp, extension_base.cpp, extension_base.hpp, mcp3021.cpp, samm8q.cpp]
2024-02-20 Send images via the TCP socket
2024-02-20 ADC Base Extension Simplification
2024-02-20 adc cleanup
2024-02-20 unit test fix with ADC config changes
    [test_adc_config.cpp]
2024-02-20 ADC Mappings initial impl
2024-02-21 full adc value mapping configuration
2024-02-21 ADC Processing
2024-06-08 remove landing predictor
2024-06-08 status LED
2024-08-10 buck converter planning
    [giraffe_flight_computer.kicad_sch, hat.kicad_sch]
2024-08-14 Power supply
    [5v Buck Supply.kicad_pcb, 5v Buck Supply.kicad_sch, 5v Power Supply.kicad_pcb, 5v Power Supply.kicad_sch, INA180A1IDBVT.step]
2024-09-18 simulated camera functional
2024-09-18 adc config loading
2024-09-22 sync hardware work
    [5015.step, 5v Buck Supply.kicad_sch, INA2180A1IDGKR.step, INA4180A1IPWR.step, SRU1048-100Y.step, TPS54302DDCR.step, TPS563201DDCR.step, untitled.kicad_sch]
2024-09-22 simplifying test supply
    [5v Buck Supply.kicad_pcb, 5v Buck Supply.kicad_sch, INA2180A1IDGKR.step, TPS54302DDCR.step]
2024-10-19 Ground Station Log
2024-10-27 Brought in v2 buck supply
    [5015.step, 5v Buck Supply.kicad_pcb, 5v Buck Supply.kicad_sch, INA180A1IDBVT.step, INA2180A1IDGKR.step, INA4180A1IPWR.step, SRU1048-100Y.step, TPS54302DDCR.step]
2024-10-28 ADC Values getting up to the data monitor
2024-10-28 Battery SOC implemented
2024-10-28 first round of updates to telemetry board
    [giraffe_flight_computer.kicad_pcb, giraffe_flight_computer.kicad_sch, hat.kicad_sch, shoe.kicad_sch]
2024-10-28 lower flight computer board schematic complete
    [giraffe_flight_computer.kicad_pcb, giraffe_flight_computer.kicad_sch, shoe.kicad_sch]
2024-11-09 5v buck supply bom and r sense
    [5v Buck Supply.kicad_sch, bom.csv, shoe.kicad_sch]
2024-11-10 sync pcb work
    [giraffe_flight_computer.kicad_pcb, shoe.kicad_sch, usb_audio_codec.kicad_sch]
2025-02-16 Initial ground station hardware (#296)
    [enclosure.FCStd]
2025-07-18 Packages, complete PCBs, Map, Install Structure
    [18650_pack.kicad_sch, 2171790001.stp, 436500301.stp, 5037630491.stp, 5V_buck_converter.kicad_sch, 5v Buck Supply.kicad_pcb, 5v Buck Supply.kicad_sch, BMI088.step]
